makeitlabs/ratt/README.md

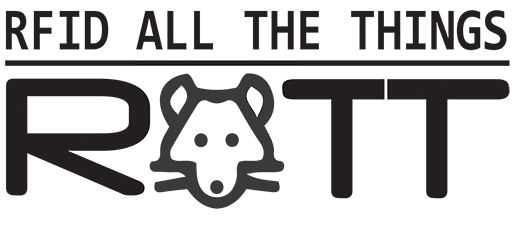
[picture p1: logo/ratt logo 512.png]
RATT - RFID All The Things


Ongoing effort to expand and improve our RFID access control system beyond building doors and onto tools and equipment.
