makeitlabs/ratt/hardware/README.md

# RATT Hardware

- `ratt` - RATT hardware design (schematic, PCB)
