makeitlabs/ratt/hardware/ratt/README.md

# RATT Logic Board

Design, fabrication files, and assembly documentation for the RATT logic board.

- `REV0` - Initial prototype (white PCB) - February 2018
- `REV1` - Design fixes (black PCB) - December 2018
