makeitlabs/ratt/attic/esp32/README.md

# ESP32 Platform projects for remote nodes

https_client_certs is adapted from an esp-idf example and demonstrates 2-way authenticated and encrypted communications from an ESP32 to our MakeItLabs authbackend (or other https site configured properly).
