makeitlabs/ratt/doc/Logic Board Block Diagram.png

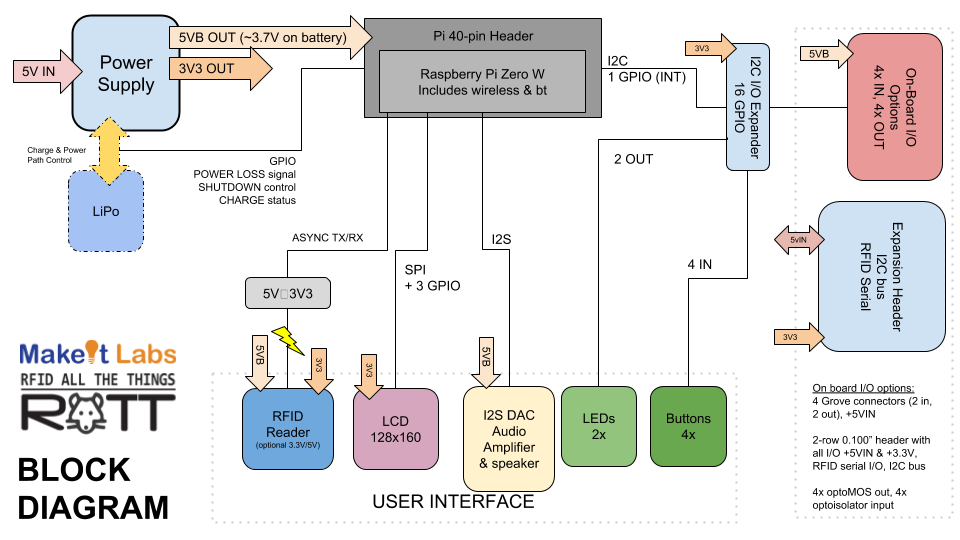
doc/Logic Board Block Diagram.png
