makeitlabs/ratt/doc/Logic Board IO Options.png

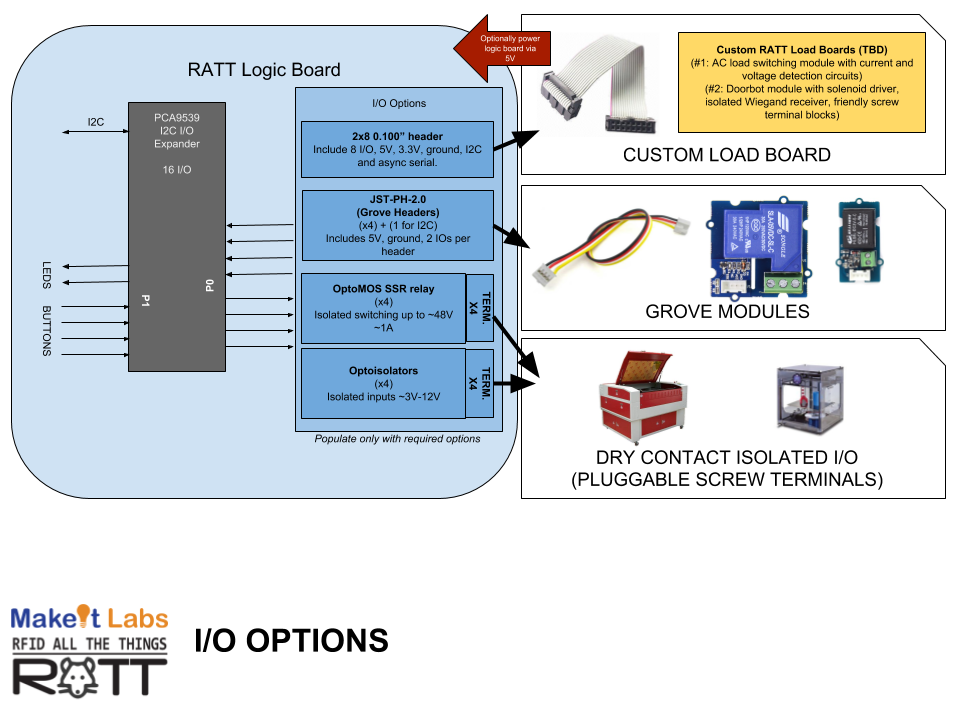
doc/Logic Board IO Options.png
