makeitlabs/ratt/hardware/ratt/references/17492753_10210264934192046_4826887455486719309_o.jpg

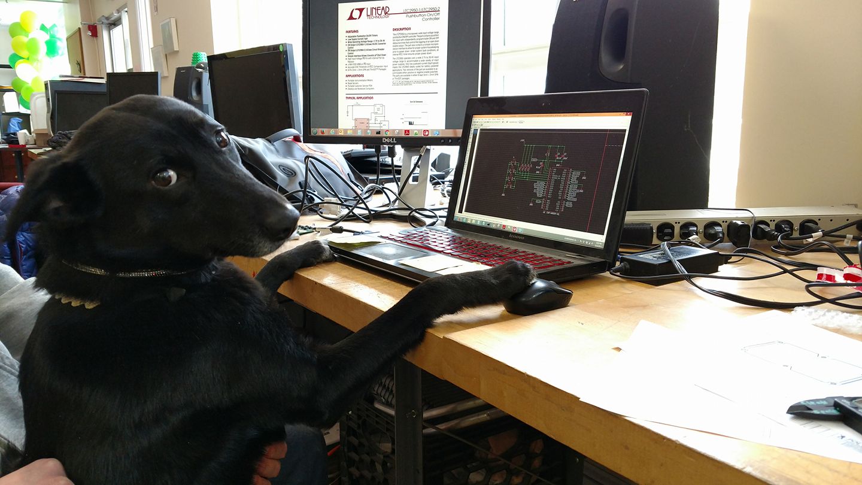
hardware/ratt/references/17492753_10210264934192046_4826887455486719309_o.jpg
