makeitlabs/ratt/hardware/ratt/references/flat,800x800,070,f.u1.bmp

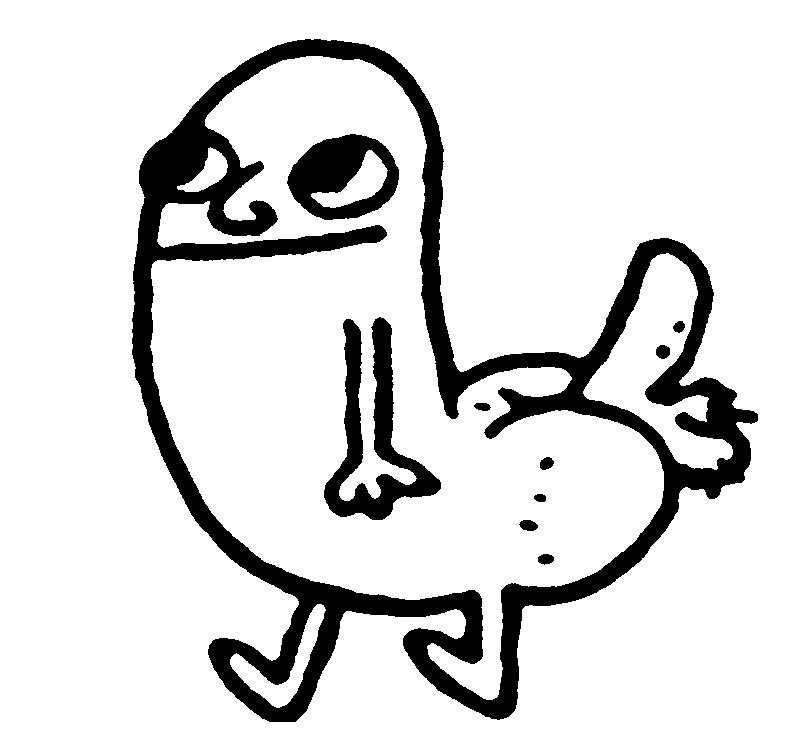
hardware/ratt/references/flat,800x800,070,f.u1.bmp
