makeitlabs/ratt/integration/AlphaBandsaw/Alpha Bandsaw RATT.png

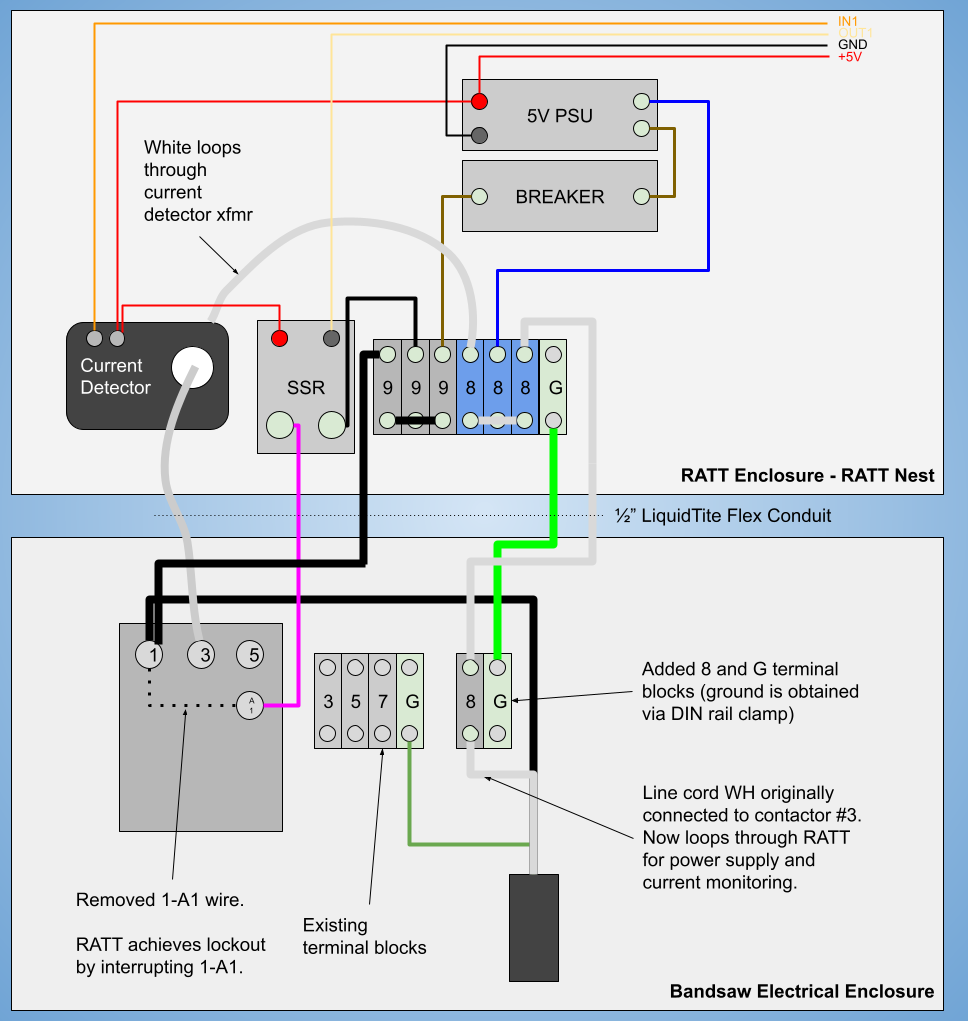
integration/AlphaBandsaw/Alpha Bandsaw RATT.png
