makeitlabs/ratt/integration/AutoLift/doc/Auto Lift - RATTsnest.png

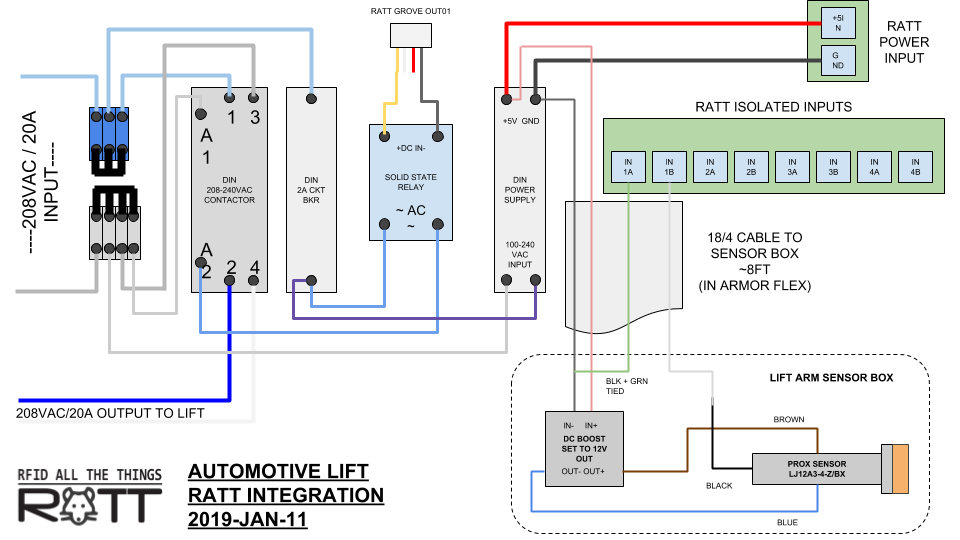
integration/AutoLift/doc/Auto Lift - RATTsnest.png
