makeitlabs/ratt/integration/FullSpectrumLaser/doc/Full Spectrum RATT Integration.png

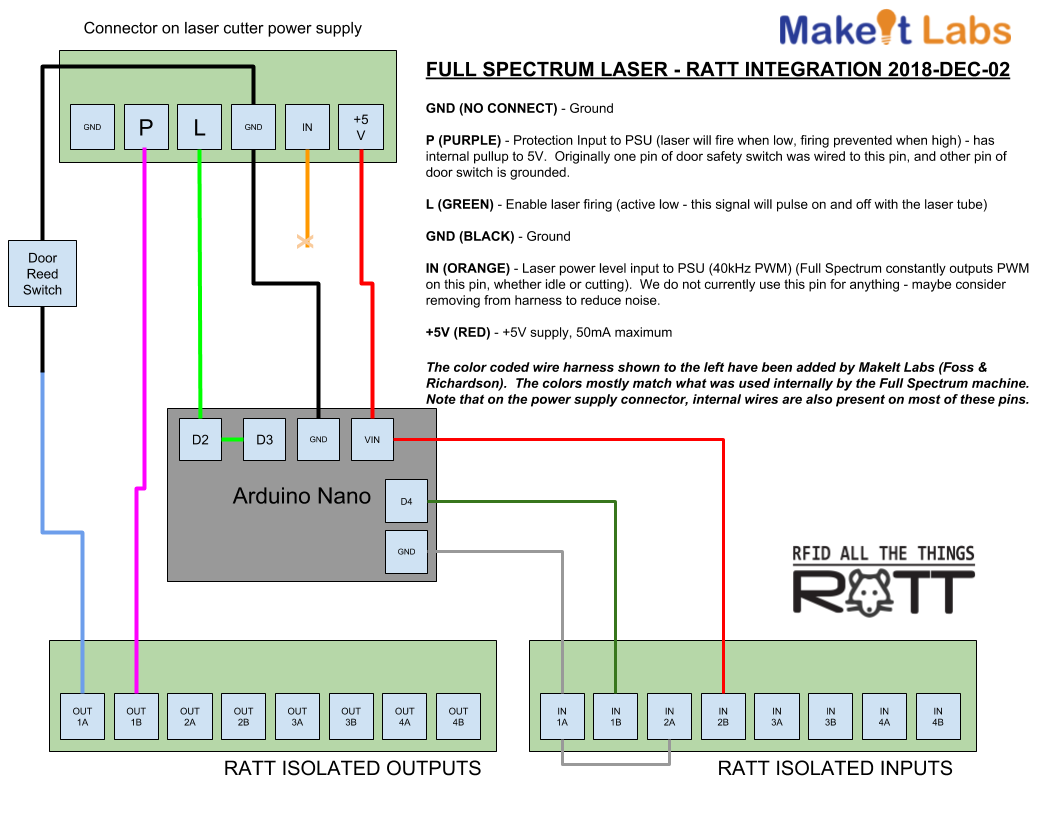
integration/FullSpectrumLaser/doc/Full Spectrum RATT Integration.png
