makeitlabs/ratt/integration/RabbitLaser/doc/Rabbit Laser Integration.png

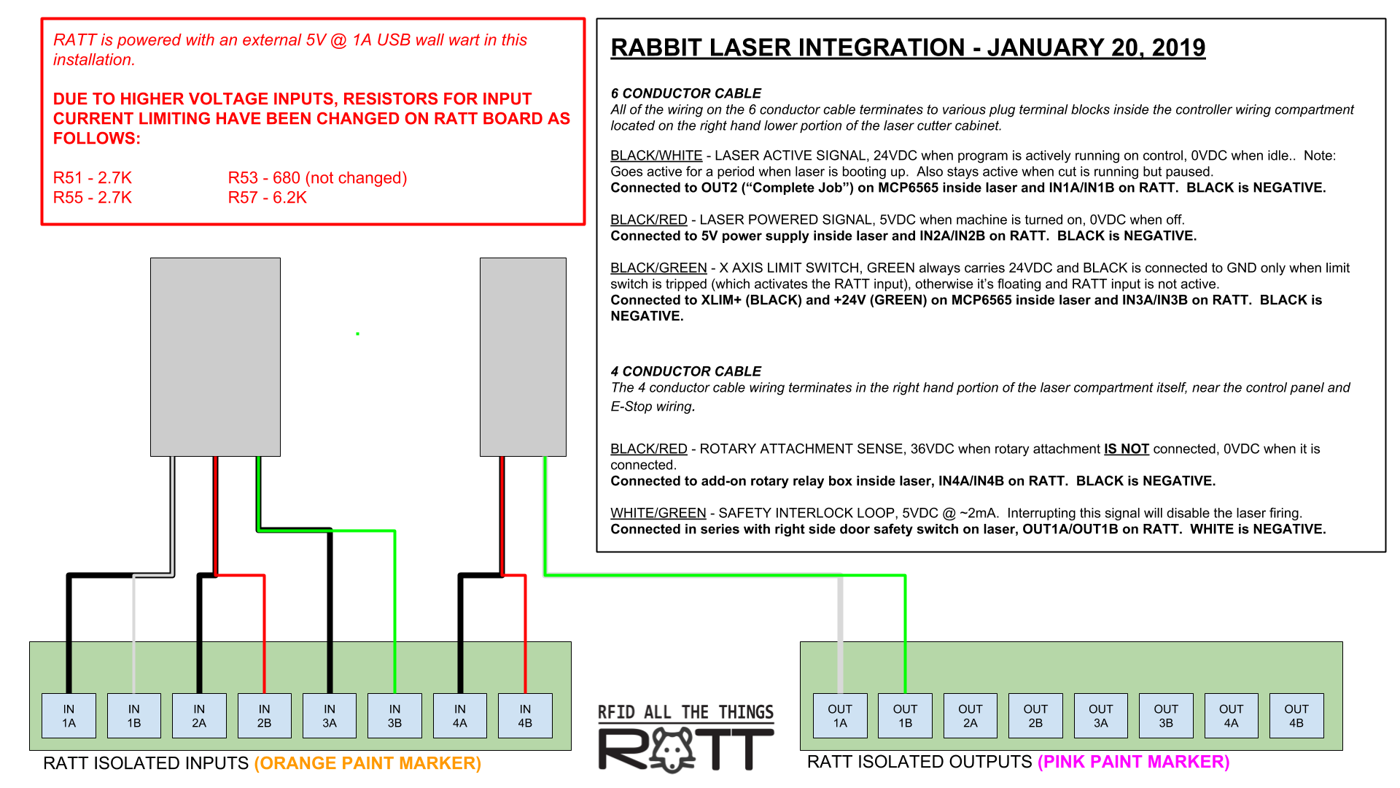
integration/RabbitLaser/doc/Rabbit Laser Integration.png
