makeitlabs/ratt/hardware/ratt/references/1.8-TFT-breakout-master/1.8-TFT-breakout-master/jdt1800-bob.dxf

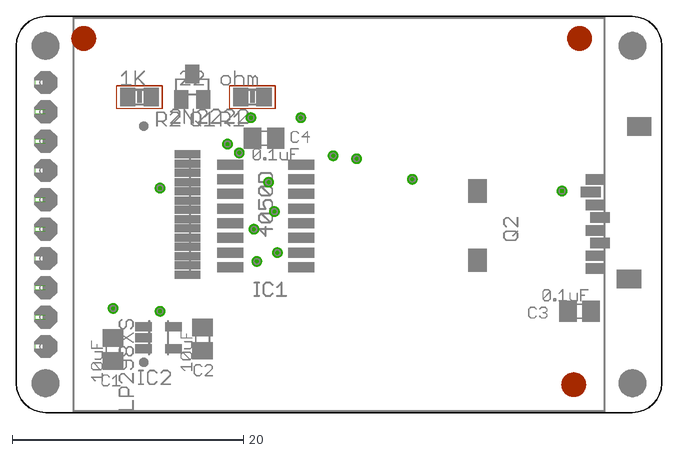
[picture p12: CAD file, 2018-01-27]
hardware/ratt/references/1.8-TFT-breakout-master/1.8-TFT-breakout-master/jdt1800-bob.dxf
55.9 x 34.3
