makeitlabs/ratt/integration/AutoLift/mechanical/led_strip_bulkhead4.stl

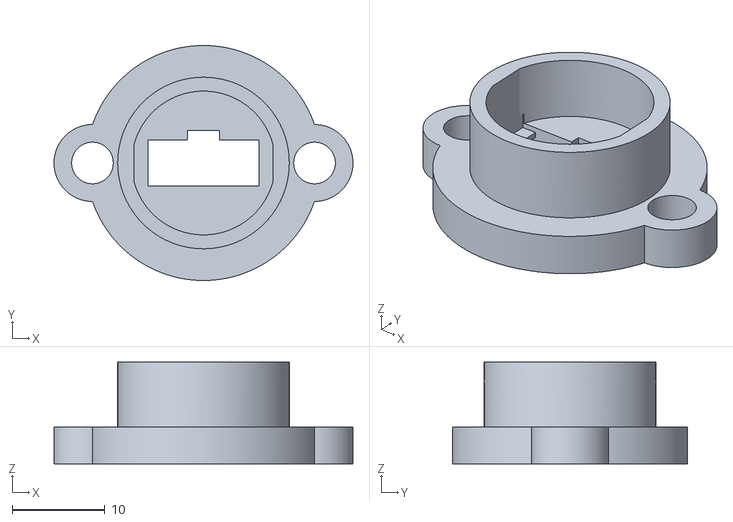
[picture p13: CAD file, 2019-03-21]
integration/AutoLift/mechanical/led_strip_bulkhead4.stl
32.3 x 25.4 x 11.0
