makeitlabs/ratt/logo/MakeIt Labs Logo 2016.dxf

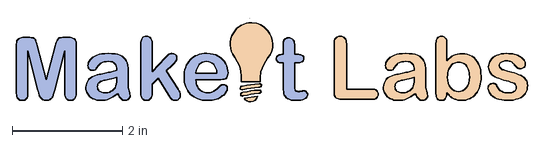
[picture p14: CAD file, 2020-12-24]
logo/MakeIt Labs Logo 2016.dxf
9.25 x 1.52 in
