makeitlabs/ratt/mechanical/RATT_Enclosure_Footprint.dxf

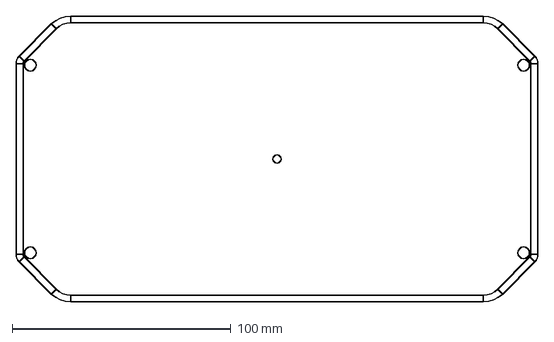
[picture p15: CAD file, 2019-01-23]
mechanical/RATT_Enclosure_Footprint.dxf
238.4 x 130.7 mm
