makeitlabs/ratt/integration/AutoLift/mechanical/led_strip_bulkhead2.stl

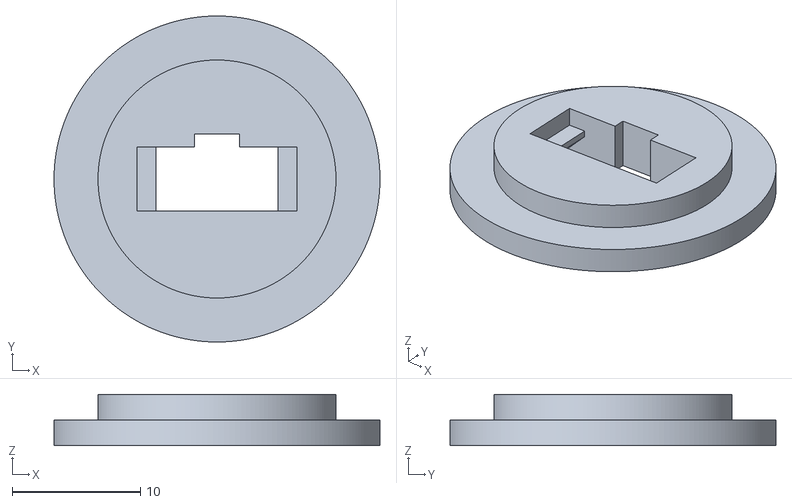
[picture p16: CAD file, 2019-03-21]
integration/AutoLift/mechanical/led_strip_bulkhead2.stl
25.4 x 25.4 x 4.00
