makeitlabs/ratt/logo/ratt logo.dxf

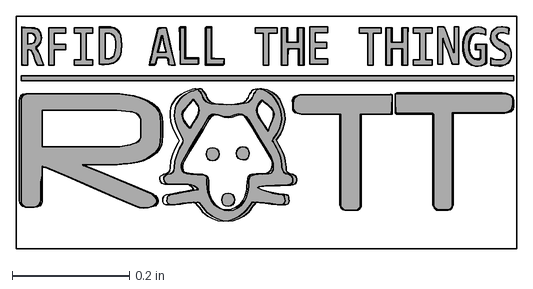
[picture p17: CAD file, 2020-12-24]
logo/ratt logo.dxf
0.853 x 0.396 in
