makeitlabs/ratt/mechanical/phoenix_support_with_rfid.stl

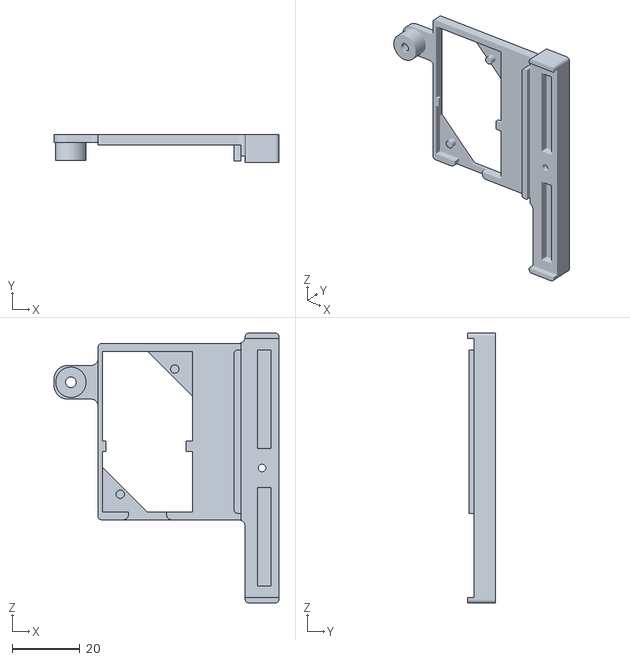
[picture p18: CAD file, 2019-01-10]
mechanical/phoenix_support_with_rfid.stl
66.6 x 8.35 x 80.0
