makeitlabs/ratt/integration/AutoLift/mechanical/led_strip_bulkhead1.stl

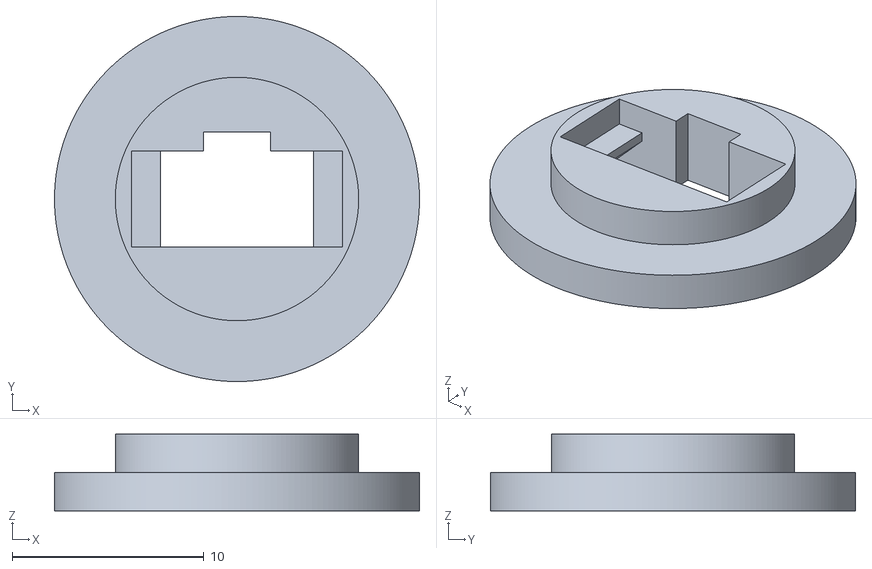
[picture p19: CAD file, 2019-03-21]
integration/AutoLift/mechanical/led_strip_bulkhead1.stl
19.0 x 19.0 x 4.00
