makeitlabs/ratt/mechanical/display_standoff.stl

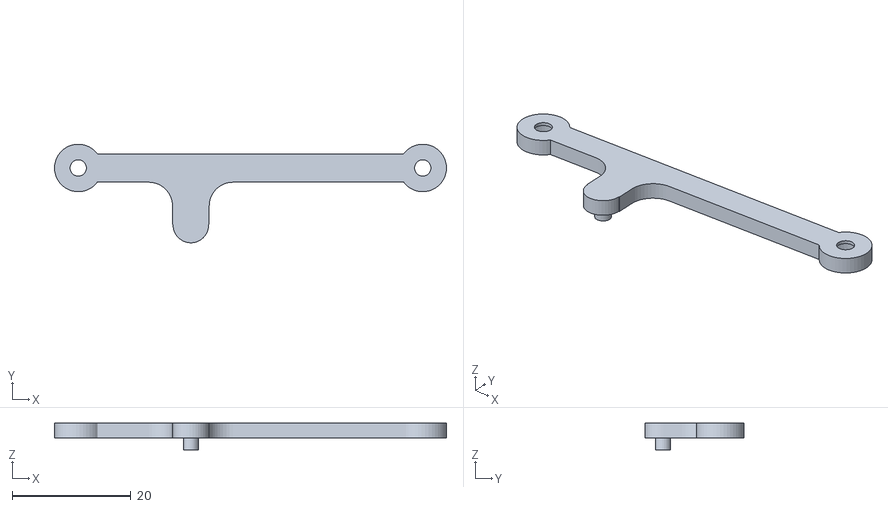
[picture p20: CAD file, 2018-12-31]
mechanical/display_standoff.stl
66.0 x 16.6 x 4.54
