makeitlabs/ratt/integration/AutoLift/mechanical/clamp_lower_sensor_12mm.stl

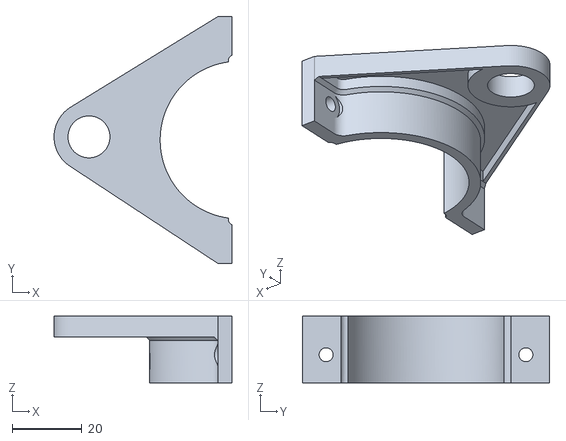
[picture p21: CAD file, 2019-03-21]
integration/AutoLift/mechanical/clamp_lower_sensor_12mm.stl
50.9 x 70.7 x 19.0
