makeitlabs/ratt/mechanical/speaker_resonator.stl

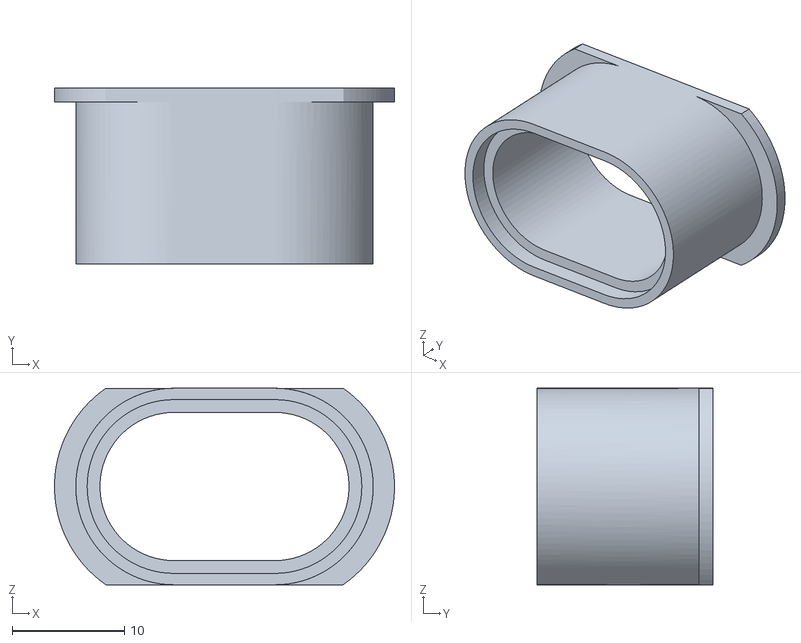
[picture p22: CAD file, 2018-12-31]
mechanical/speaker_resonator.stl
30.3 x 15.7 x 17.5
