makeitlabs/ratt/integration/AutoLift/mechanical/led_strip_bulkhead3.stl

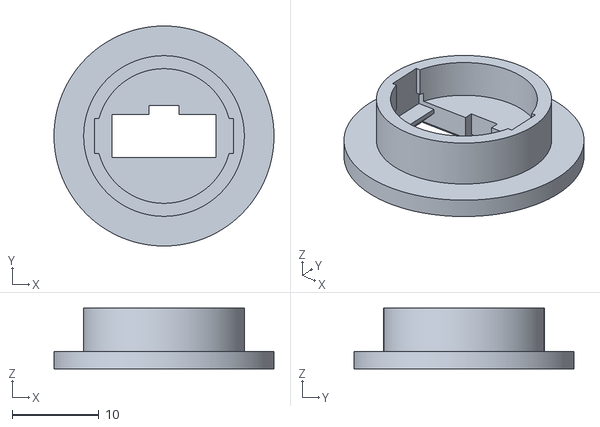
[picture p23: CAD file, 2019-03-21]
integration/AutoLift/mechanical/led_strip_bulkhead3.stl
25.4 x 25.4 x 7.00
