makeitlabs/ratt/mechanical/pi_standoff_2.stl

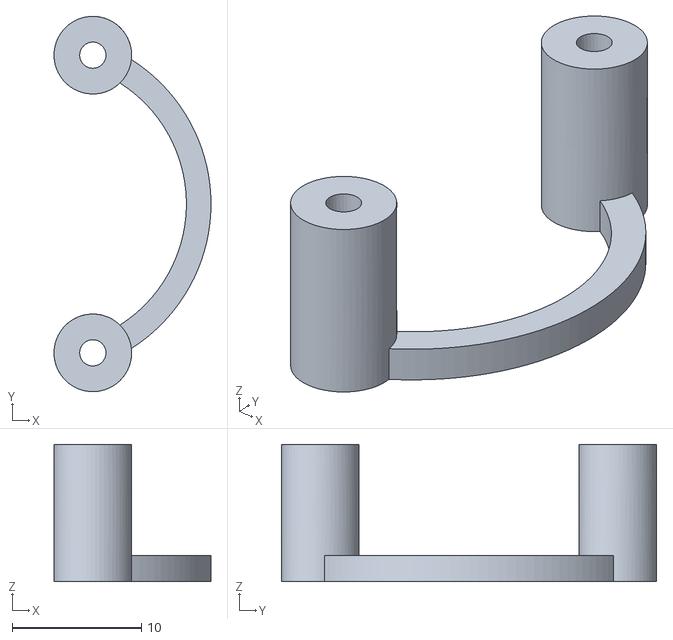
[picture p24: CAD file, 2018-12-31]
mechanical/pi_standoff_2.stl
12.1 x 29.0 x 10.6
