makeitlabs/ratt/integration/AutoLift/mechanical/indicator_acrylic_3mm.dxf

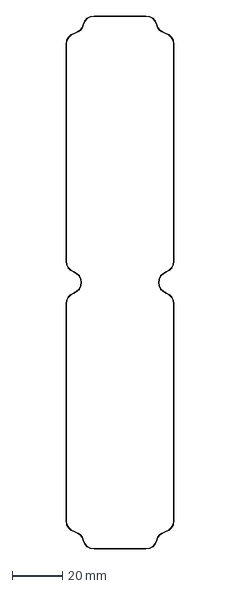
[picture p25: CAD file, 2019-01-31]
integration/AutoLift/mechanical/indicator_acrylic_3mm.dxf
43.0 x 213.0 mm
