makeitlabs/ratt/mechanical/pi_standoff_1.stl

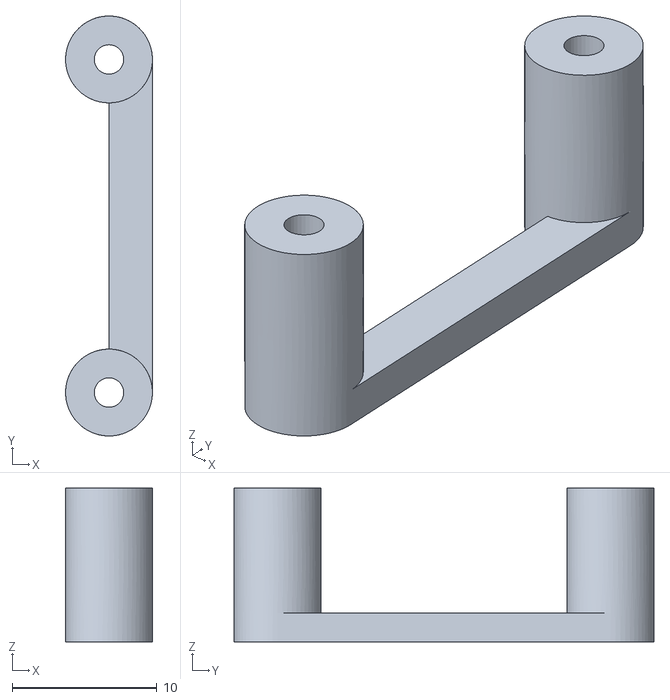
[picture p26: CAD file, 2018-12-31]
mechanical/pi_standoff_1.stl
6.00 x 29.0 x 10.6
