makeitlabs/ratt/integration/AutoLift/mechanical/indicator_bottom.stl

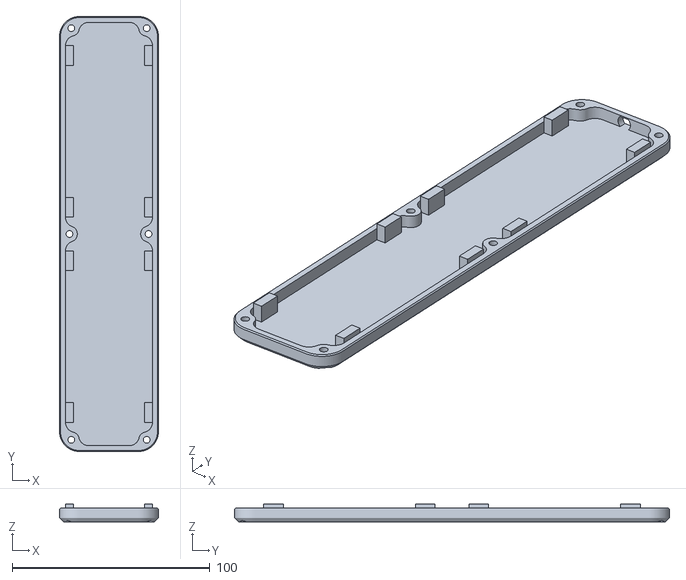
[picture p27: CAD file, 2019-01-31]
integration/AutoLift/mechanical/indicator_bottom.stl
50.0 x 220.0 x 9.00
