makeitlabs/ratt/integration/AutoLift/mechanical/indicator_top.stl

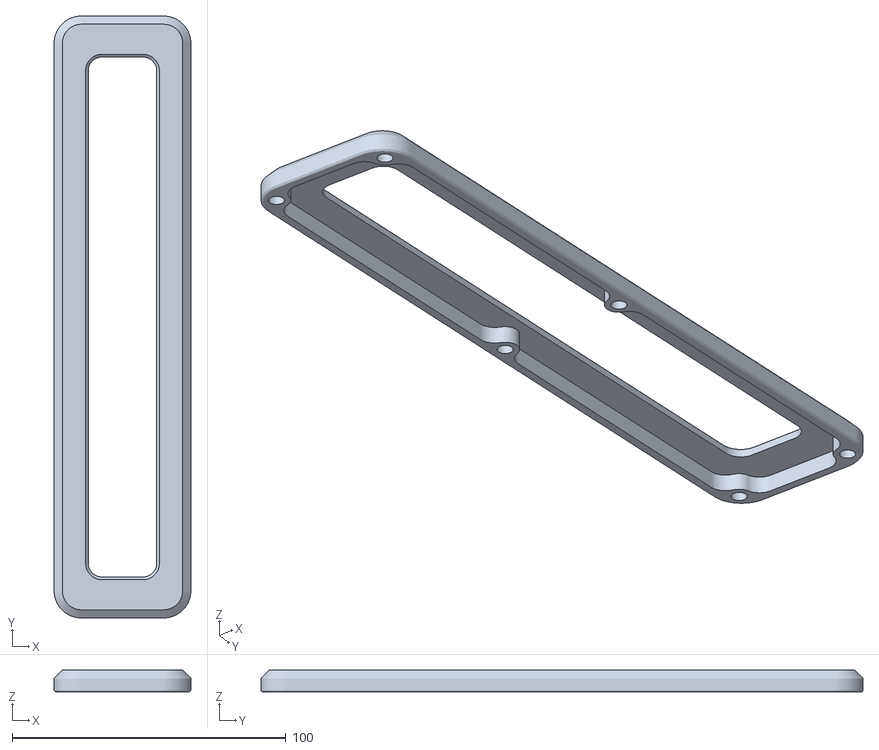
[picture p28: CAD file, 2019-01-31]
integration/AutoLift/mechanical/indicator_top.stl
50.0 x 220.0 x 8.00
