makeitlabs/ratt/integration/AutoLift/mechanical/indicator_separator.stl

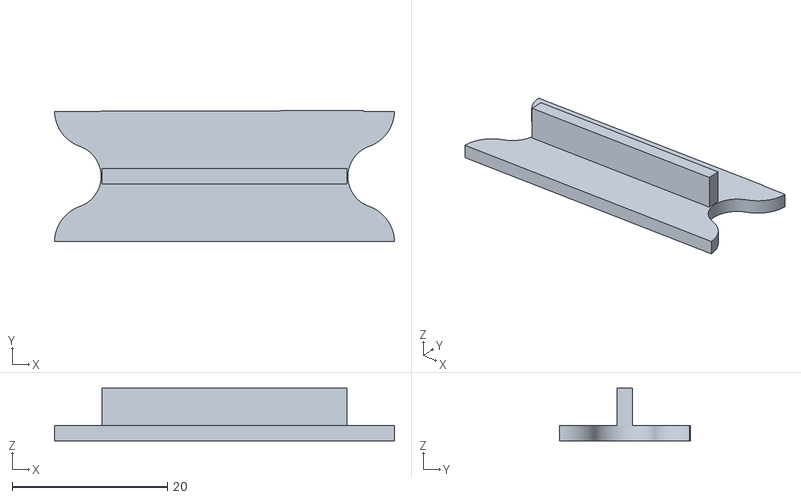
[picture p29: CAD file, 2019-01-31]
integration/AutoLift/mechanical/indicator_separator.stl
43.8 x 16.9 x 6.80
