makeitlabs/ratt/integration/AutoLift/mechanical/clamp_lower1.stl

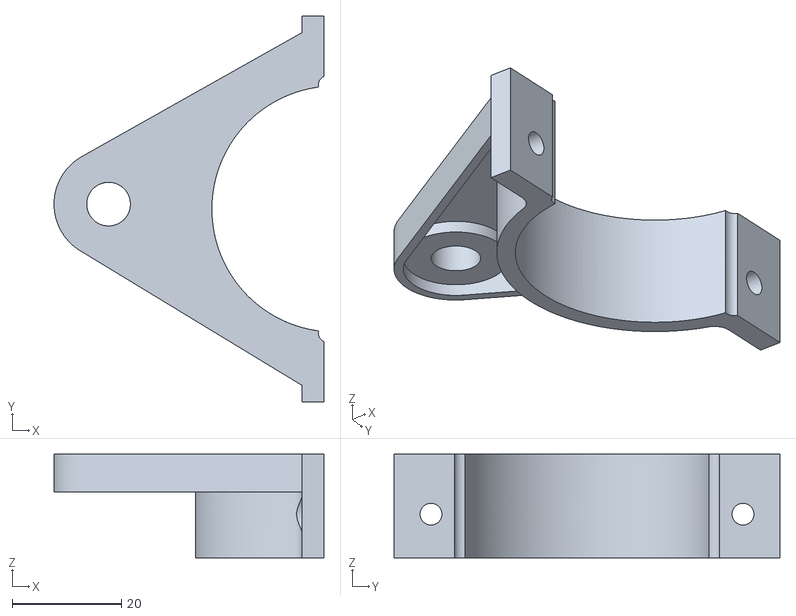
[picture p30: CAD file, 2019-01-23]
integration/AutoLift/mechanical/clamp_lower1.stl
49.5 x 70.7 x 19.0
