makeitlabs/ratt/integration/AutoLift/mechanical/clamp_upper1.stl

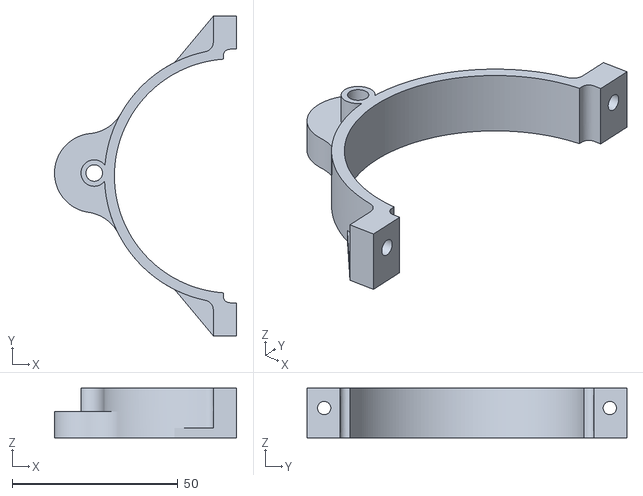
[picture p31: CAD file, 2019-01-23]
integration/AutoLift/mechanical/clamp_upper1.stl
55.0 x 96.6 x 15.0
