makeitlabs/ratt/integration/AutoLift/mechanical/clamp_upper2.stl

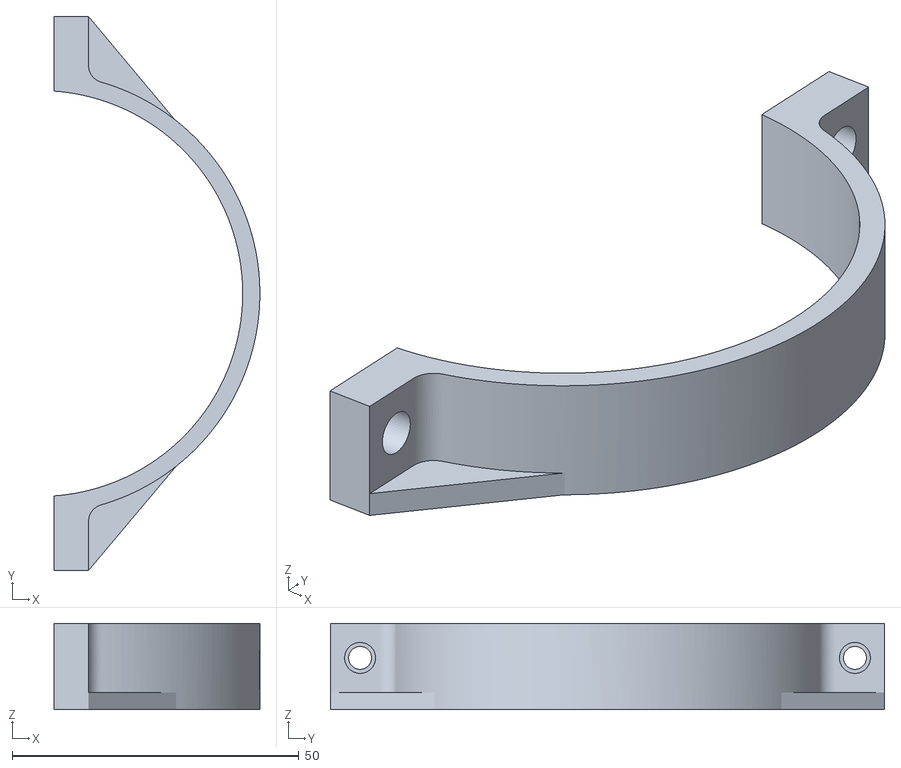
[picture p32: CAD file, 2019-01-23]
integration/AutoLift/mechanical/clamp_upper2.stl
35.9 x 96.6 x 15.0
