makeitlabs/ratt/integration/AutoLift/mechanical/clamp_lower2.stl

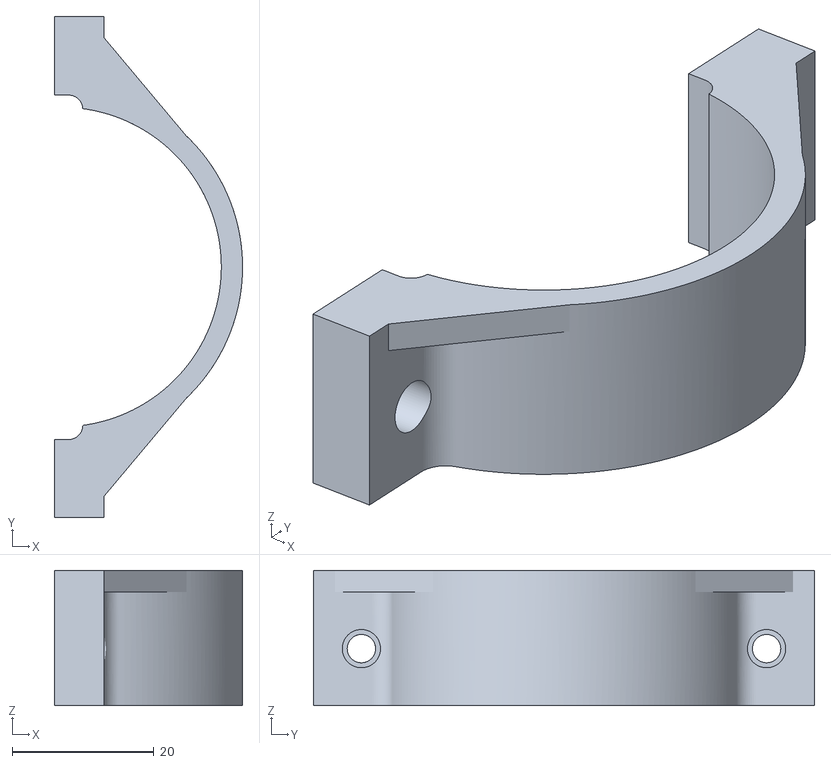
[picture p33: CAD file, 2019-01-23]
integration/AutoLift/mechanical/clamp_lower2.stl
26.5 x 70.7 x 19.0
