makeitlabs/ratt/(list of files, cad)

Other CAD files:
hardware/ratt/REV0/assembly/RATT_REV0.dxf
hardware/ratt/REV0/assembly/RATT_TOP0.dxf
integration/Deprecated/FullSpectrumLaser/mechanical/Bottom Half Plate for Arduino Screw Terminal Breakout.dxf
integration/FullSpectrumLaser/mechanical/Bottom Half Plate for Arduino Screw Terminal Breakout.dxf
