makeitlabs/ratt/(threads)

Thread 1 (2019-01-25):

PersonalityLaserCutter: Flaws in homing/power logic

tangentaudio, 2019-01-25:
When the laser cutter personality is used with the homing requirement enabled, there are some instances where the user may home the laser but RATT cannot detect this due tot he narrow window in which homing is expected.

Possible fixes:

- force homing upon detection of laser powerup instead of upon RFID badge-in (minor downside: can't report homing failure by user, since they would not be badged in yet)
- detect homed condition during idle loop (may not reliably detect given RATT may transition into other states, or may have to make code super ugly to detect in multiple places)
- don't boot user out of 'homing required' state if laser activity detected, play warning and keep requiring homing
- homing signal from laser is momentary, so possibly add hardware latch that resets whenever laser is power cycled - this means RATT would see that the laser had been homed no matter when it was done, and the homing state would be retained as long as laser was powered.  (downside: adding hardware, level conversions between 24V homing signal, etc.)

tangentaudio, 2019-02-02:
There's another issue that occasionally comes up.  Due to the way the Rabbit laser controller works at bootup, it indicates to RATT that it is active for the duration of the controller bootup process (5-10 seconds).  If someone tags into RATT right after powering it up, RATT thinks they started a job and will complain.

It might be nice to have an optional sequence after tool powerup detected to make sure the active state goes active then inactive, and puts up a nice friendly message to tell the user to wait for the laser to boot.  RFID reads would be ignored during this time.

tangentaudio, 2020-10-06:
I believe there is also a memory leak in some part of this RATT personality.  The Rabbit laser is the only one of the four deployed which will get slow/unresponsive after a period of time of running.  My guess is possibly in the QML with the audio prompts that play, but that's purely a shot in the dark.  Needs investigation.

tangentaudio, 2022-08-22:
Since we have retired the Rabbit laser, I am closing this issue.  The bugs still exist, but no longer impact our day-to-day operations.

Closed 2022-08-22.

Thread 2 (2019-01-25):

MQTT logout message missing when homing fails

tangentaudio, 2019-01-25:
Noted on PersonalityLaserCutter - if a user badges in and RATT is asking for homing, but the user starts the laser job instead, RATT will issue a warning and go back to the idle loop.

In that case, RATT will have sent an MQTT personality login message when the user badged in, and another message with the safety failure occurred.  However, it does not send a logout message like it should.

I looked at the code a bit and this should be easy to fix, but currently all logout messages are sent from the QML side (because usually they're accompanied by usage time stats, which are generated in the QML view).

To improve consistency, considering extending the 'uiEvent' (which is sent from QML and used in the personality state machine in Python) to include a json payload which could be used to carry the usage stats, and moving all of the logout messages into the personality state machine.  Then an additional logout message would be added to the state machine to handle this case.

It should be checked whether this same situation occurs with the normal safety failure in PersonalitySimple.  The laser cutter homing routine hooks into the safety check, so if a single fix can be done to address both that is best.

tangentaudio, 2019-02-02:
Fixed by tracking the 'logged in' state inside the member record.  When returning to the idle state, it will check if the 'logged in' flag is still set and issue a logout mqtt message with reason='other'.  Normal logouts will issue the logout mqtt message themselves and then set the member record as logged out so this 'fall through' won't occur.

Closed 2019-02-02.

Thread 4 (2019-01-25):

Timeout for RFID swipe on "Report Issue"

bkgoodman, 2019-01-25:
"Report issue" should have a timeout waiting for the user's RFID swipe. It currently has none. It gets confusing when the next user swipes-in (maybe significantly later) - and inadvertently sends the last-user's pending message, and is not logged in.

(If it does have one - it's probably too long).

tangentaudio, 2019-02-02:
Fixed, there is now a 30 second timeout for the entire issue reporting process.  Keypresses reset the timeout timer.  Also added an "exit (no issue to report" issue as first item, and fixed bug with empty issue report when exiting.

Closed 2019-02-02.

Thread 6 (2019-03-23):

Option to remain logged-in when idle

bkgoodman, 2019-03-23:
When you are working - and clock is ticking down to auto-timeout, it would be nice to have SOME way of preventing this - like [preferably] hitting a button or _even_ re-swiping RFID.

It sucks to watch the clock count down when you're not ready to run - knowing that you'll have to re-badge-in in 15 seconds.

tangentaudio, 2019-03-25:
Yes - this one is easy and I've been meaning to do it.   I think I will allow a button press to restart the countdown.

Re-swiping RFID would at least prevent coat-tailing but I think it's probably a bit too inconvenient to be worth it.  We can also increase the default timeout on the particular tool if it seems a bit too short.

tangentaudio, 2019-03-29:
Fixed, any user may now simply press the blue button when logged in to reset their idle timer to the value configured by `[Personality] TimeoutSeconds` in the config file.

Closed 2019-03-29.

Thread 7 (2019-03-24):

Camera board unaware of power-offs

bkgoodman, 2019-03-24:
Login to resource - use resource - then KIlL POWER to RATT. Camera signboard still things user is using resource - hours later?

tangentaudio, 2019-03-25:
Indeed - there are a few circumstances which can cause this.  This is really an issue with the Node-RED logic running on the backend, I just need to put some time into making it a bit smarter and more robust.

Thread 8 (2019-03-28):

Laser wouldn't work - Half-stuck in "zero-XY mode"?

bkgoodman, 2019-03-28:
I was using the laser - everything was fine. Powering on and off, timing out, re-logging in, etc.

At one point I noticed the RATT was beeping - like it does when it is waiting for Zero-XY. I had already done the homing, and the screen was NOT telling me to do so again. It was a bit of an unexplained annoyance.

At one point I went to cut - and laser would not fire. I checked everything - tried re badging in, even tried re-homing laser. It kept beeping, and still would not fire.

Eventually I killed power to RATT. When it came back up - I homed - and all worked well from there.

tangentaudio, 2022-08-22:
Closing this issue since we have retired the Rabbit laser.  The bugs still exist, but no longer impact day-to-day operation.

Closed 2022-08-22.

Thread 15 (2019-11-15):

Lockout message displays raw JSON

bkgoodman, 2019-11-15:
Currently displays like:
`{"reason":"Maintenance","tool":"laser-rabbit"}`

Should display like:

Something else

tangentaudio, 2020-10-06:
Fixed by brad - merged from PR, tested by Steve.

Closed 2020-10-06.
