makeitlabs/ratt/hardware/ratt/REV1/assembly/RATT_REV1_assembly_connectors.pdf

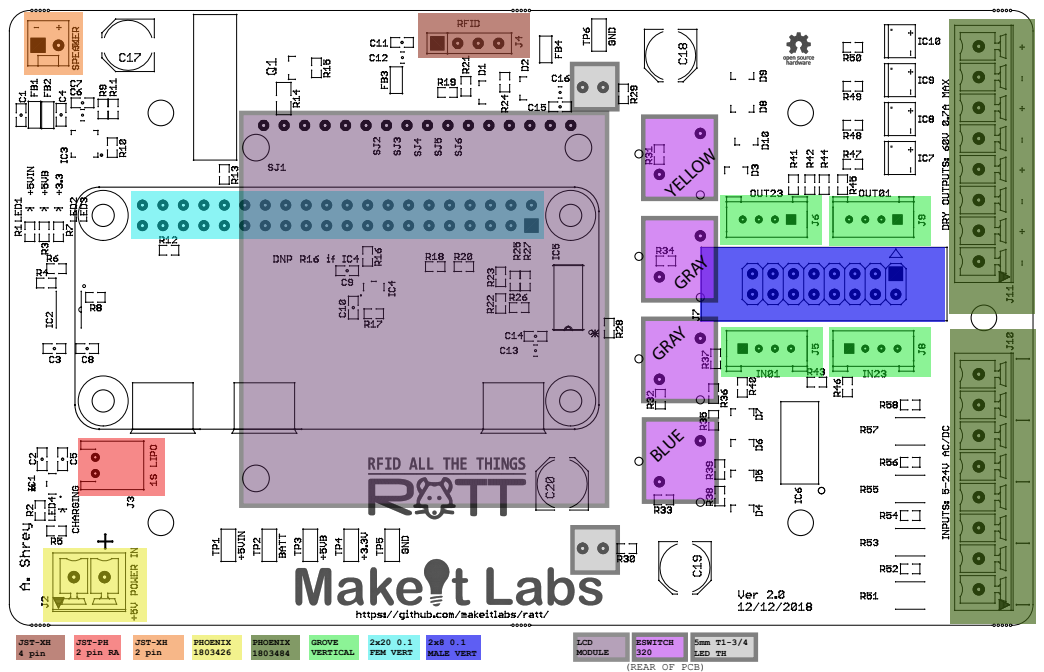
[picture p35: page 1]
JST-XH 4 pin; JST-PH 2 pin RA; JST-XH 2 pin; PHOENIX 1803426; PHOENIX 1803484; GROVE VERTICAL; 2x20 0.1 FEM VERT; 2x8 0.1 MALE VERT; ESWITCH 320; 5mm T1-3/4 LED TH; YELLOW; BLUE; GRAY

LCD
MODULE
(REAR OF PCB)
