makeitlabs/ratt/hardware/ratt/REV1/assembly/RATT_REV1_assembly_other.pdf

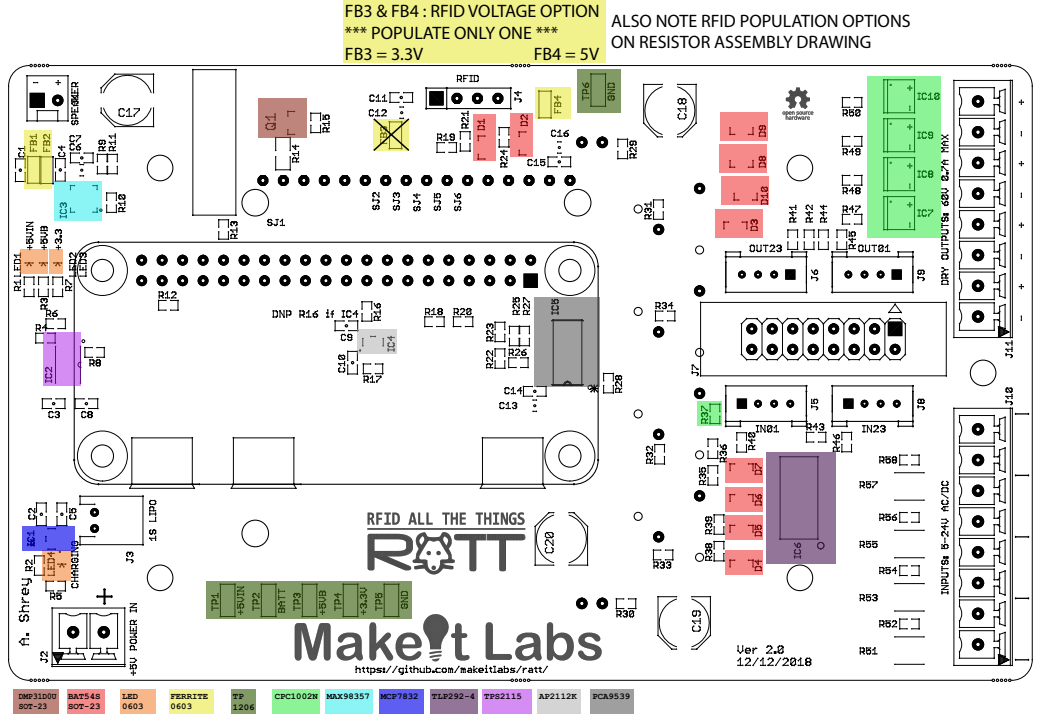
[picture p36: page 1]
DMP31D0U SOT-23; BAT54S SOT-23; LED 0603; FERRITE 0603; CPC1002N MAX98357 MCP7832 TLP292-4 TPS2115 AP2112K PCA9539

FB3 & FB4 : RFID VOLTAGE OPTION
*** POPULATE ONLY ONE ***

ALSO NOTE RFID POPULATION OPTIONS
ON RESISTOR ASSEMBLY DRAWING
