makeitlabs/ratt/hardware/ratt/REV1/assembly/RATT_REV1_assembly_resistors.pdf

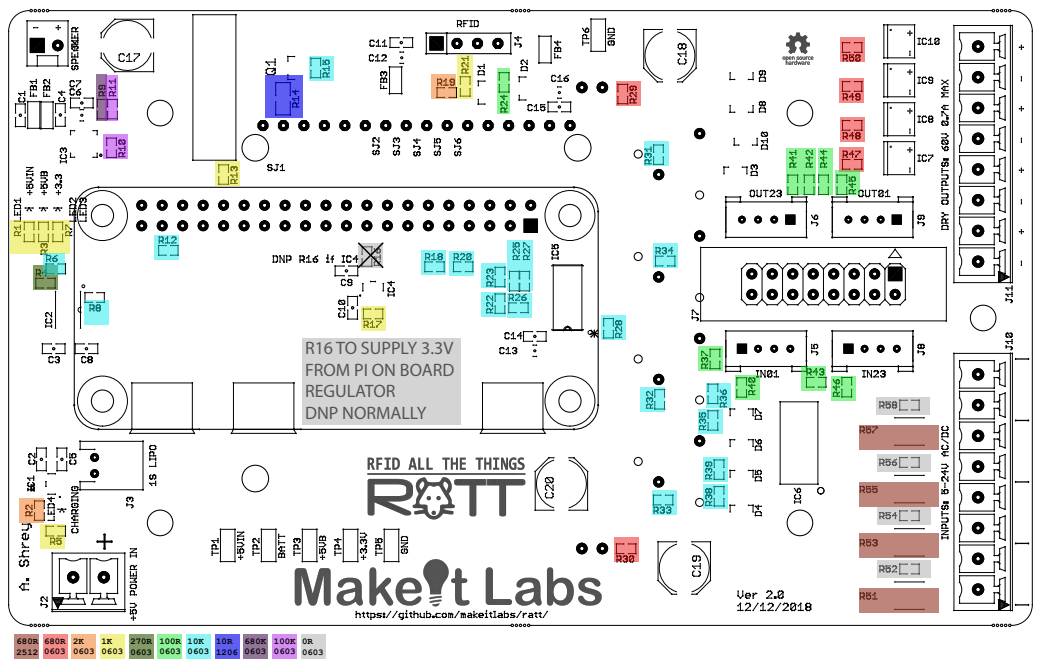
[picture p37: page 1]

R16 TO SUPPLY 3.3V
FROM PI ON BOARD
REGULATOR
DNP NORMALLY
