makeitlabs/ratt/hardware/ratt/REV1/assembly/RATT_REV1_schematic.pdf

## Charge current: I_CHG = 1000 / R_PROG

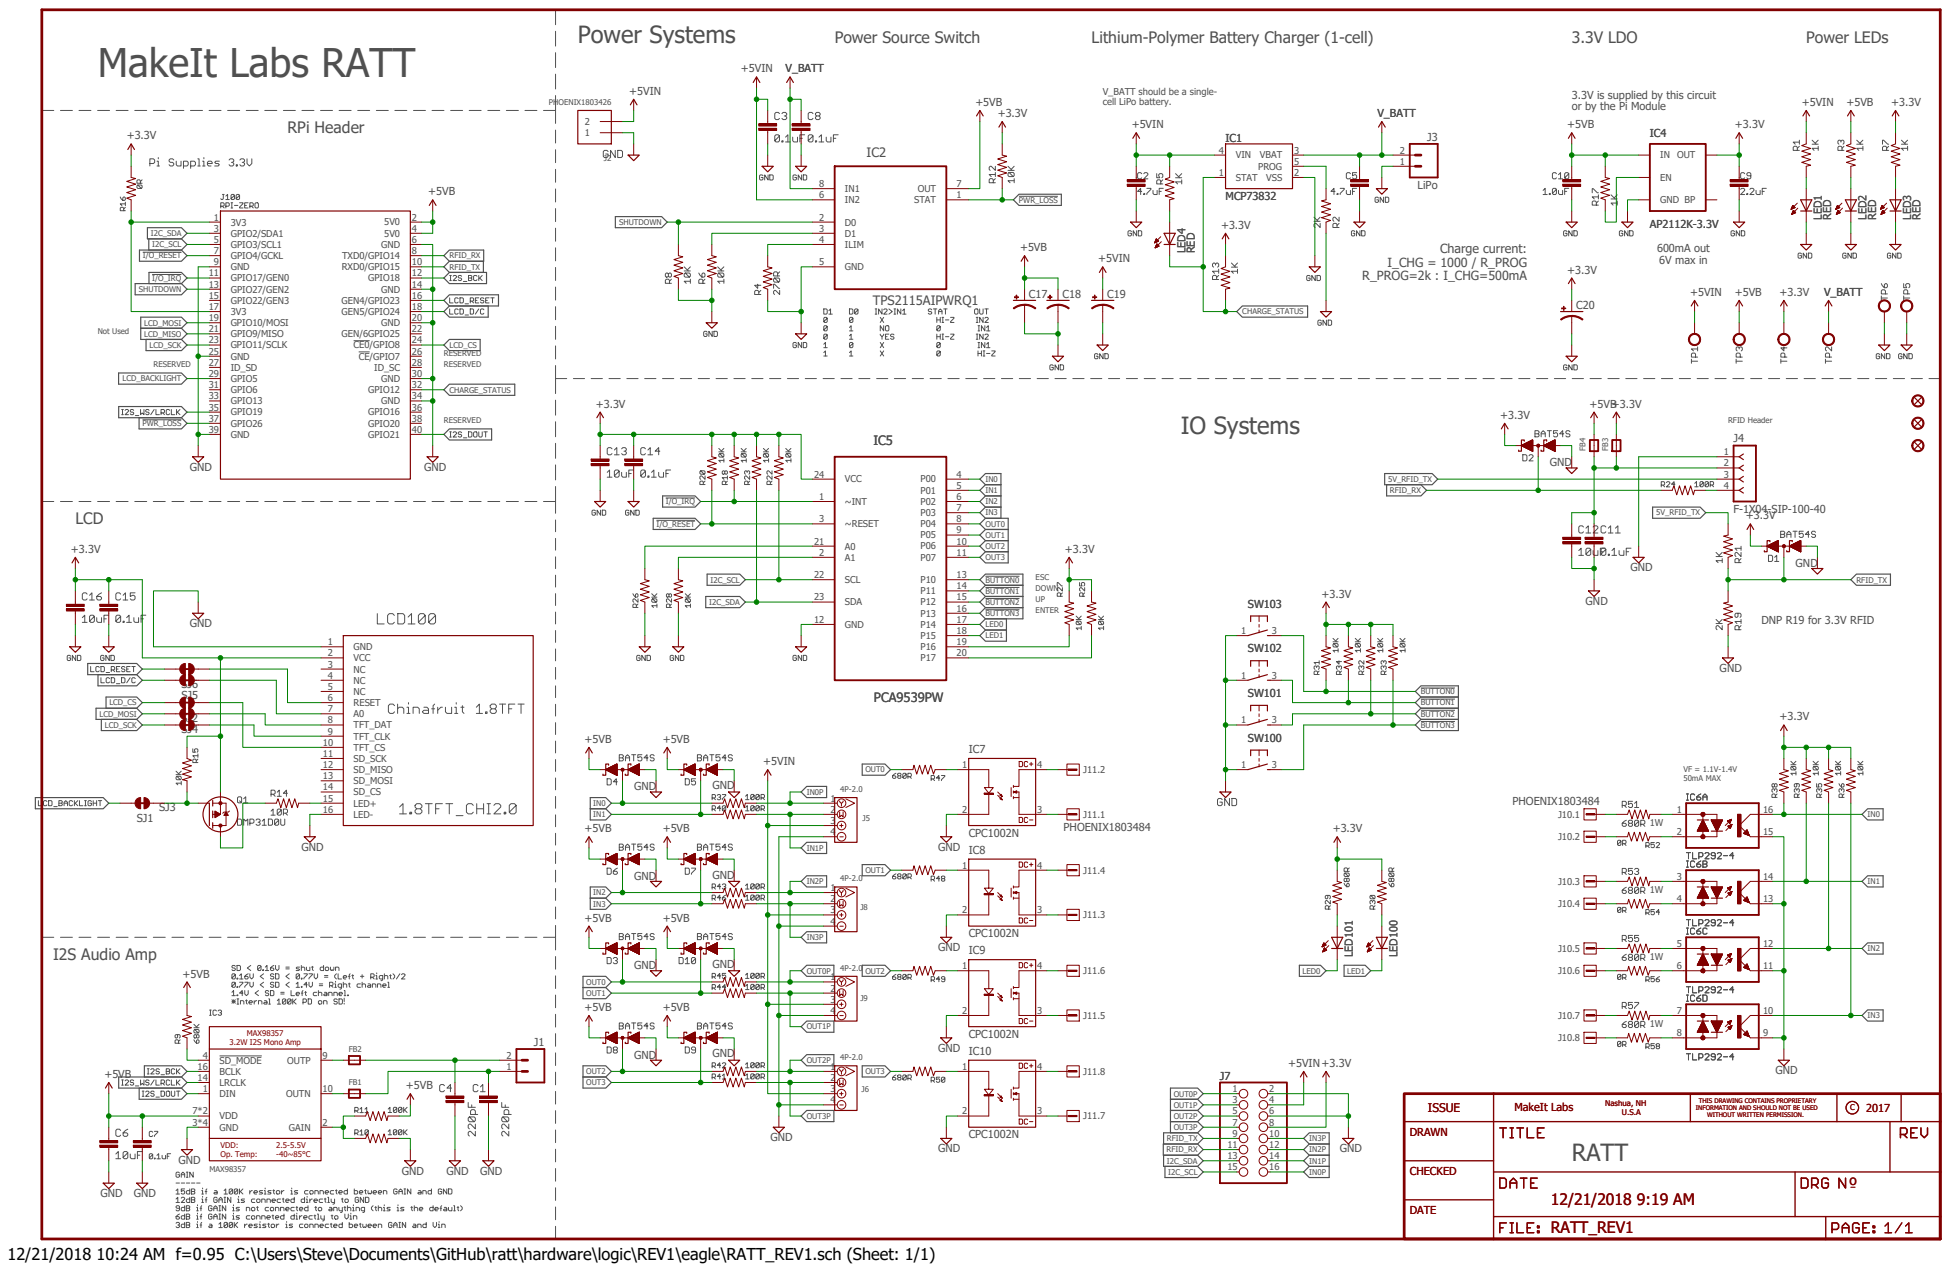
[picture p38: page 1]

Lithium-Polymer Battery Charger (1-cell)

3.3V is supplied by this circuit
or by the Pi Module

12/21/2018 10:24 AM f=0.95 C:\Users\Steve\Documents\GitHub\ratt\hardware\logic\REV1\eagle\RATT_REV1.sch (Sheet: 1/1)
