makeitlabs/ratt/integration/AutoLift/doc/Auto Lift - RATTsnest.pdf

1 3
A

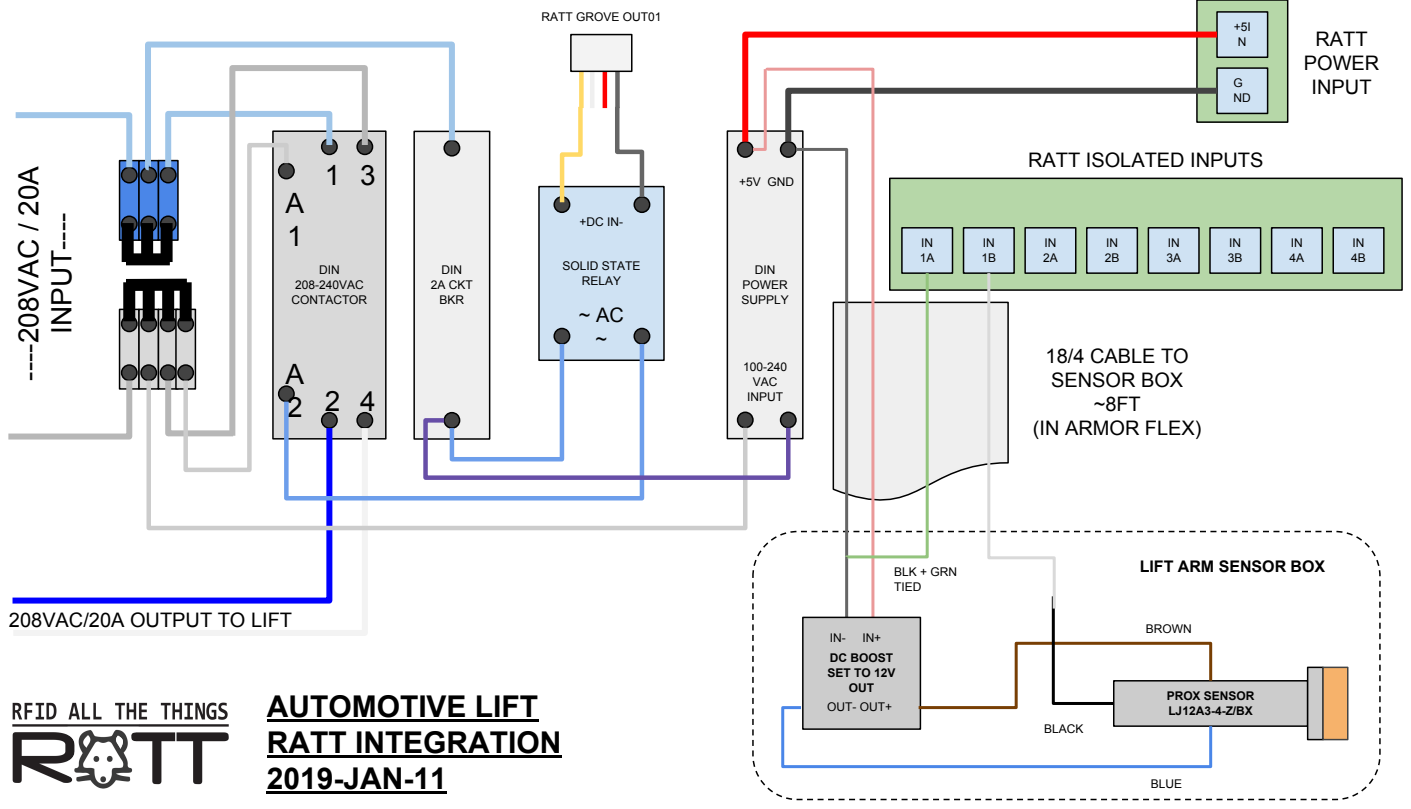
[picture p39: page 1]
DIN 208-240VAC CONTACTOR; DIN 2A CKT BKR; SOLID STATE RELAY; DIN POWER SUPPLY; 100-240 VAC INPUT; +5V GND; ----208VAC / 20A; INPUT----; RATT POWER INPUT; RATT GROVE OUT01; DC BOOST SET TO 12V OUT; OUT- OUT+; PROX SENSOR LJ12A3-4-Z/BX; BROWN; BLUE; BLACK; 18/4 CABLE TO SENSOR BOX ~8FT; BLK + GRN TIED; AUTOMOTIVE LIFT RATT INTEGRATION 2019-JAN-11

RATT ISOLATED INPUTS

(IN ARMOR FLEX)

LIFT ARM SENSOR BOX

208VAC/20A OUTPUT TO LIFT
