makeitlabs/ratt/mechanical/Polycase_DC85F.pdf

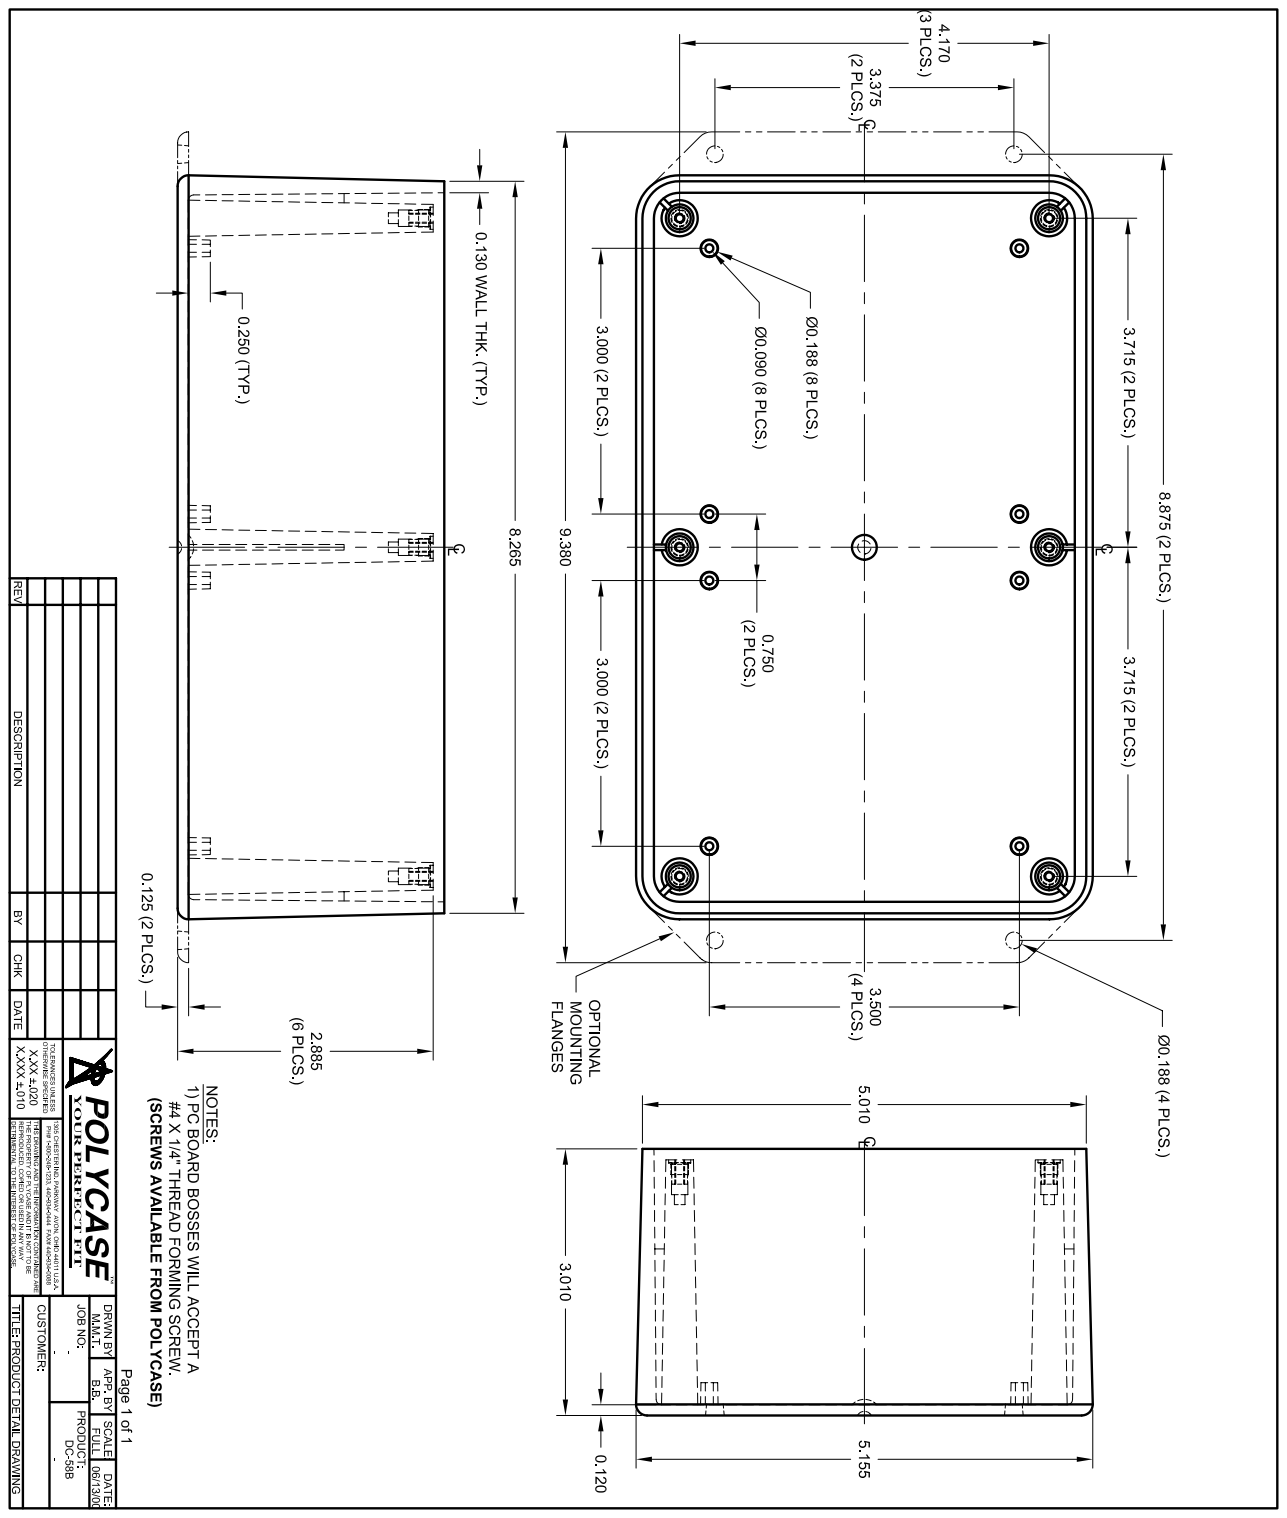
[picture p40: page 1]

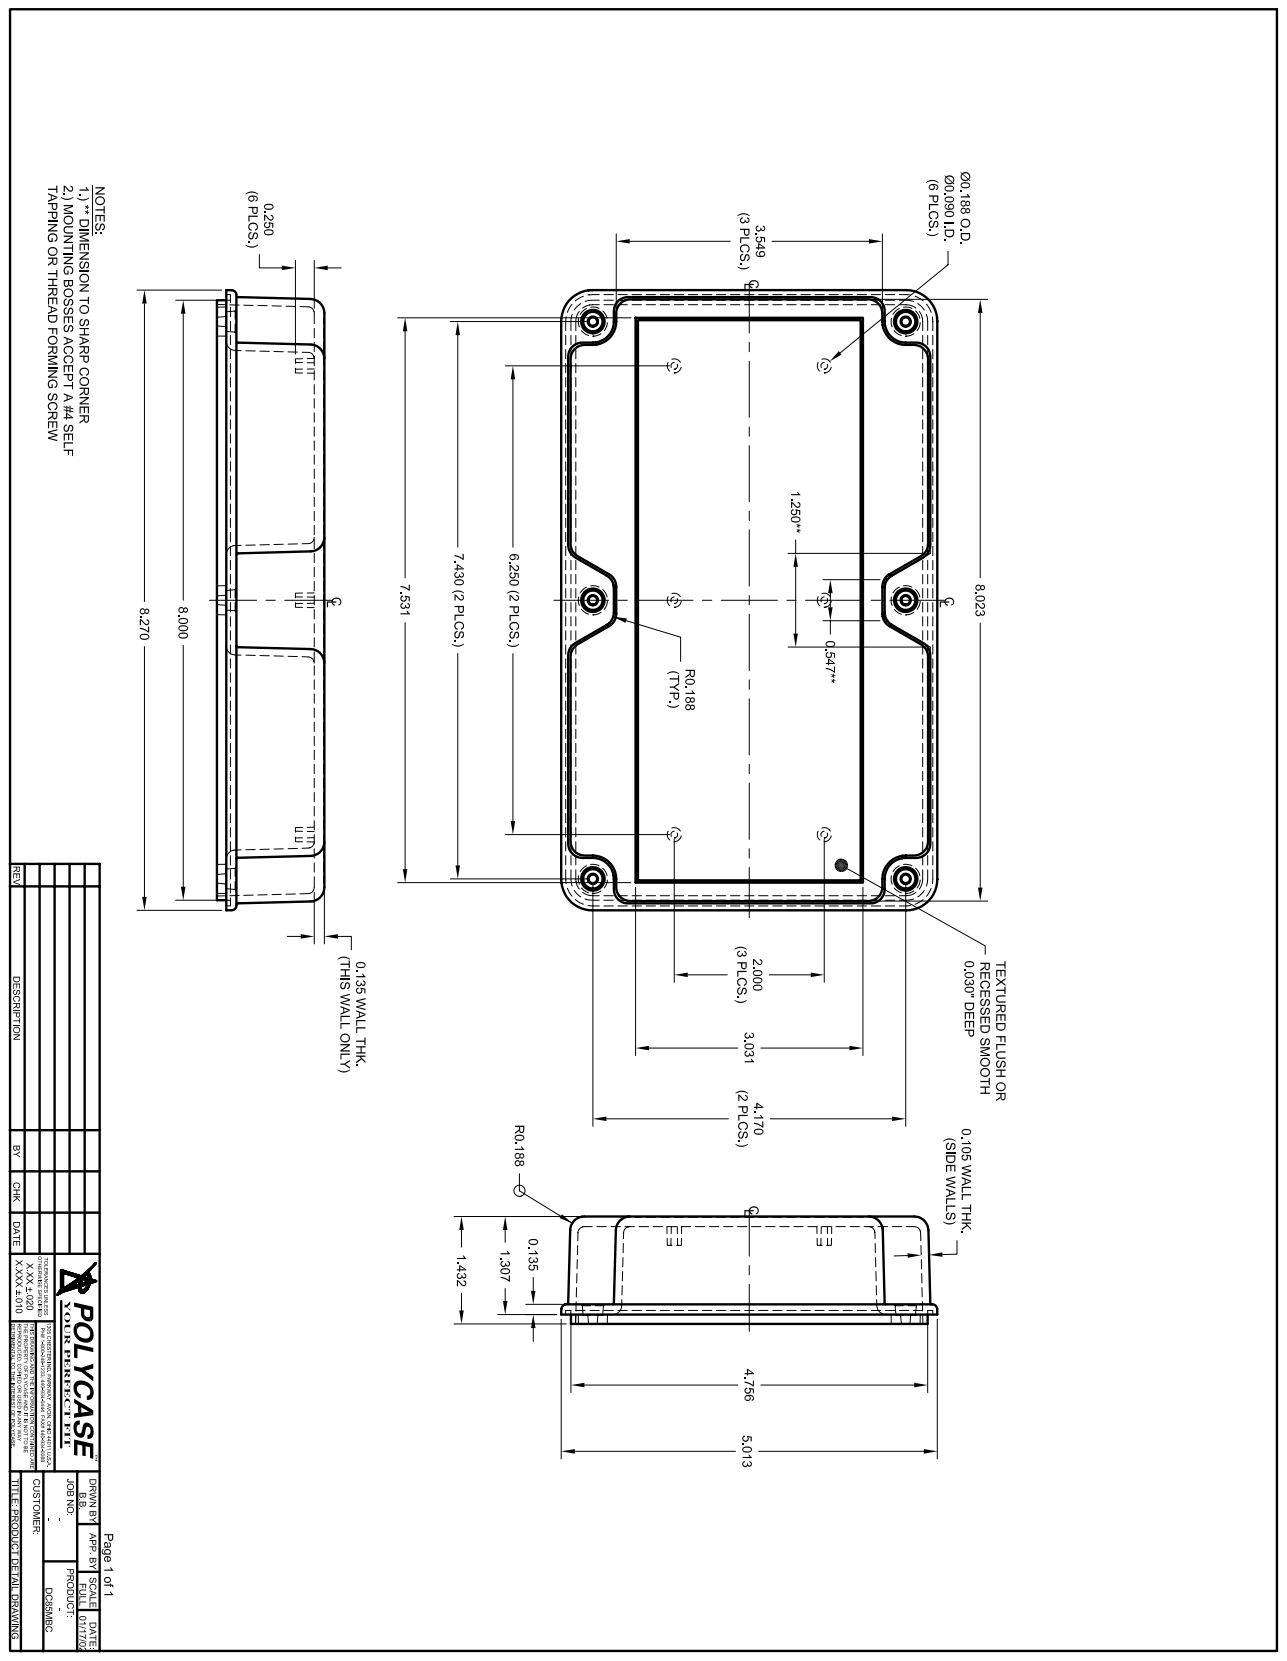
[picture p41: page 2]
