makeitlabs/ratt/mechanical/RATT_Enclosure_Footprint.pdf

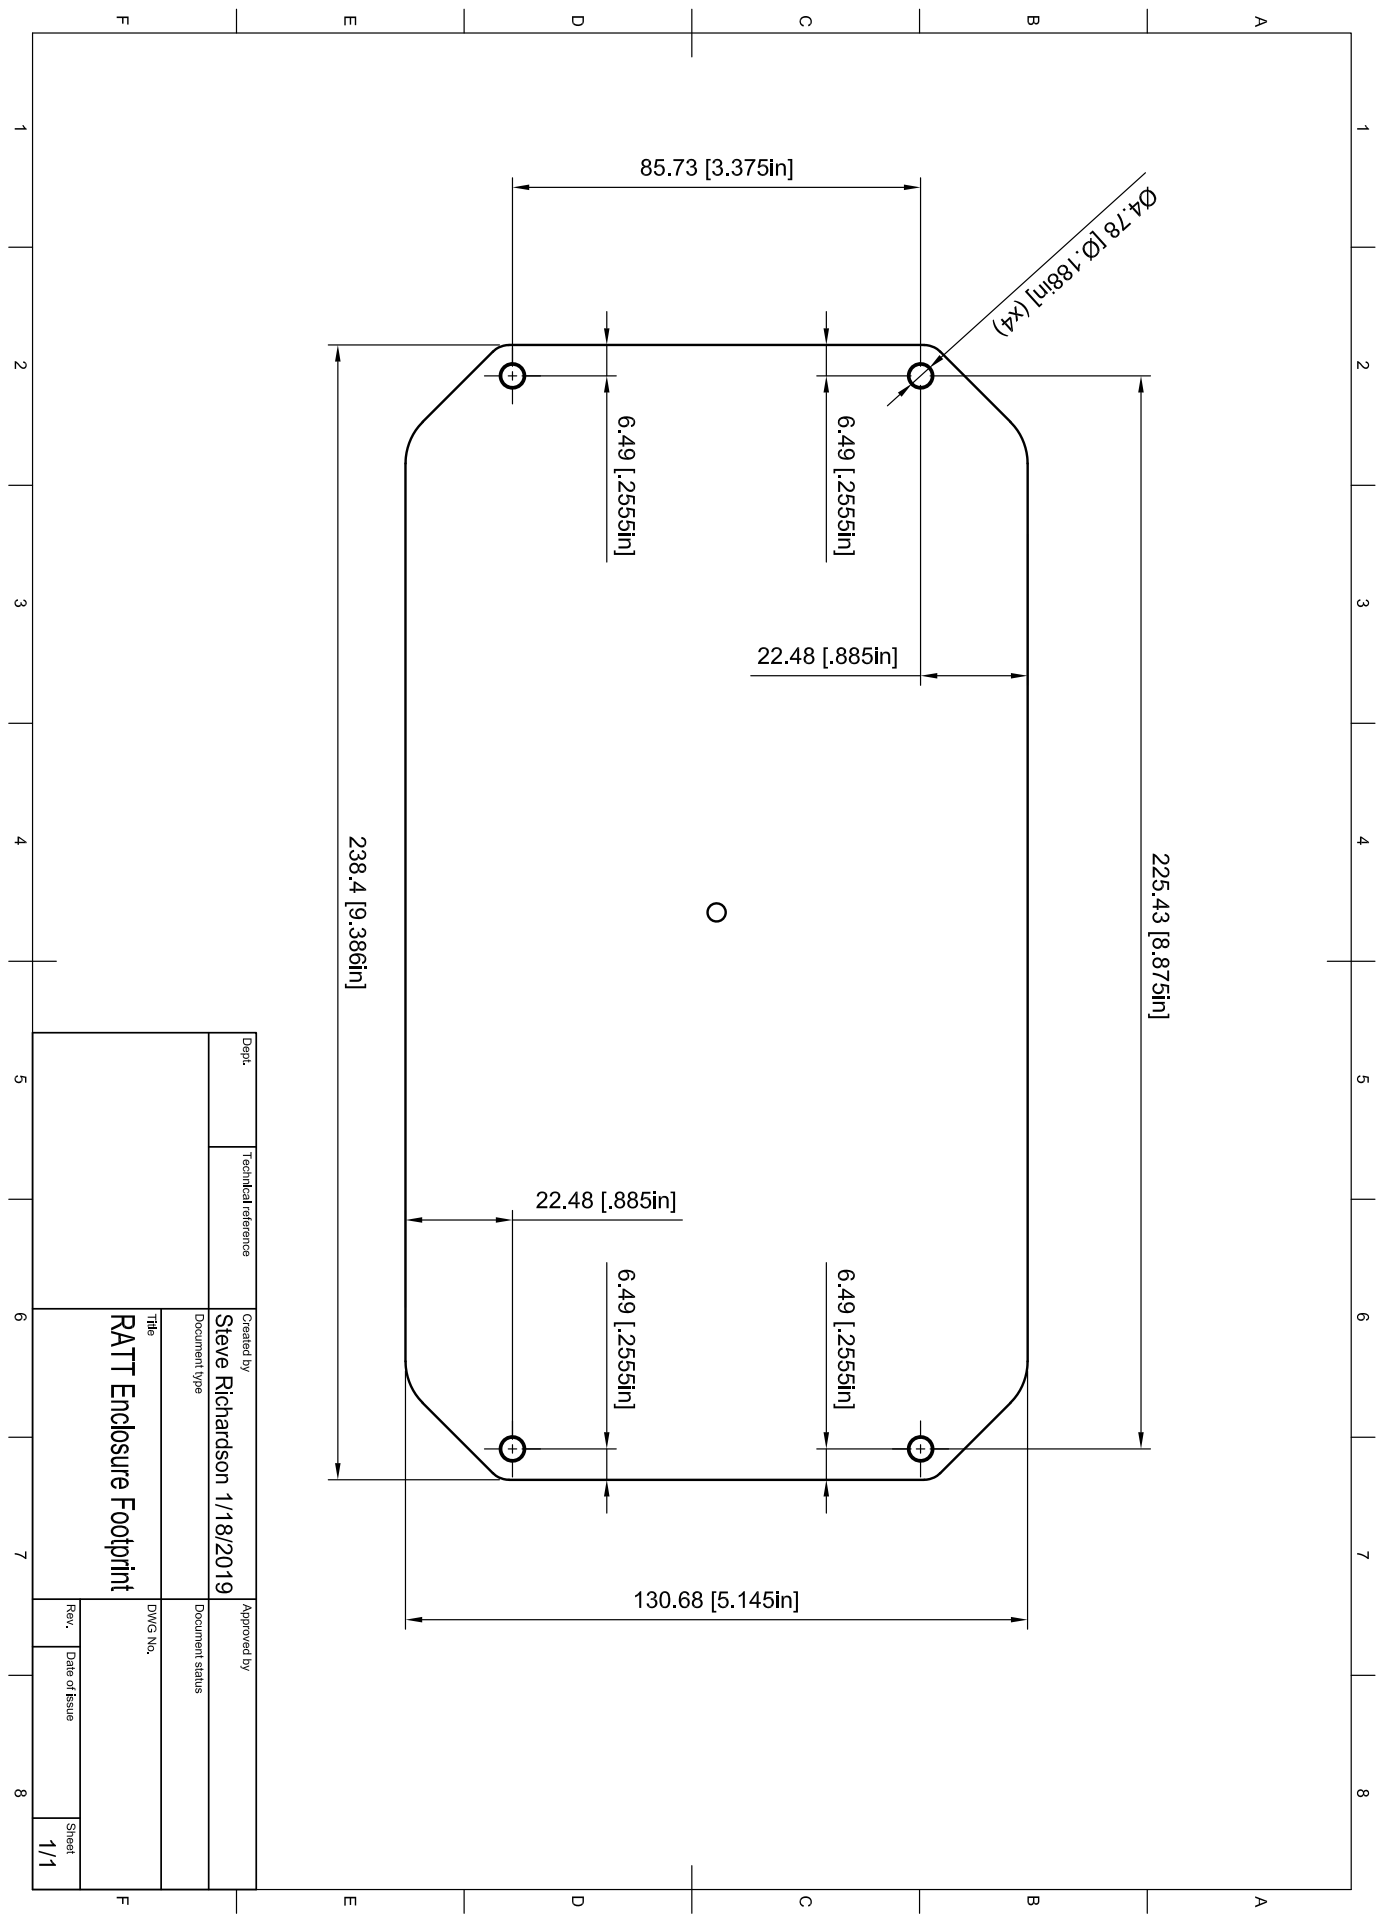
[picture p42: page 1]
