makeitlabs/ratt/integration/MopaLaser/MOPA Wiring.pdf

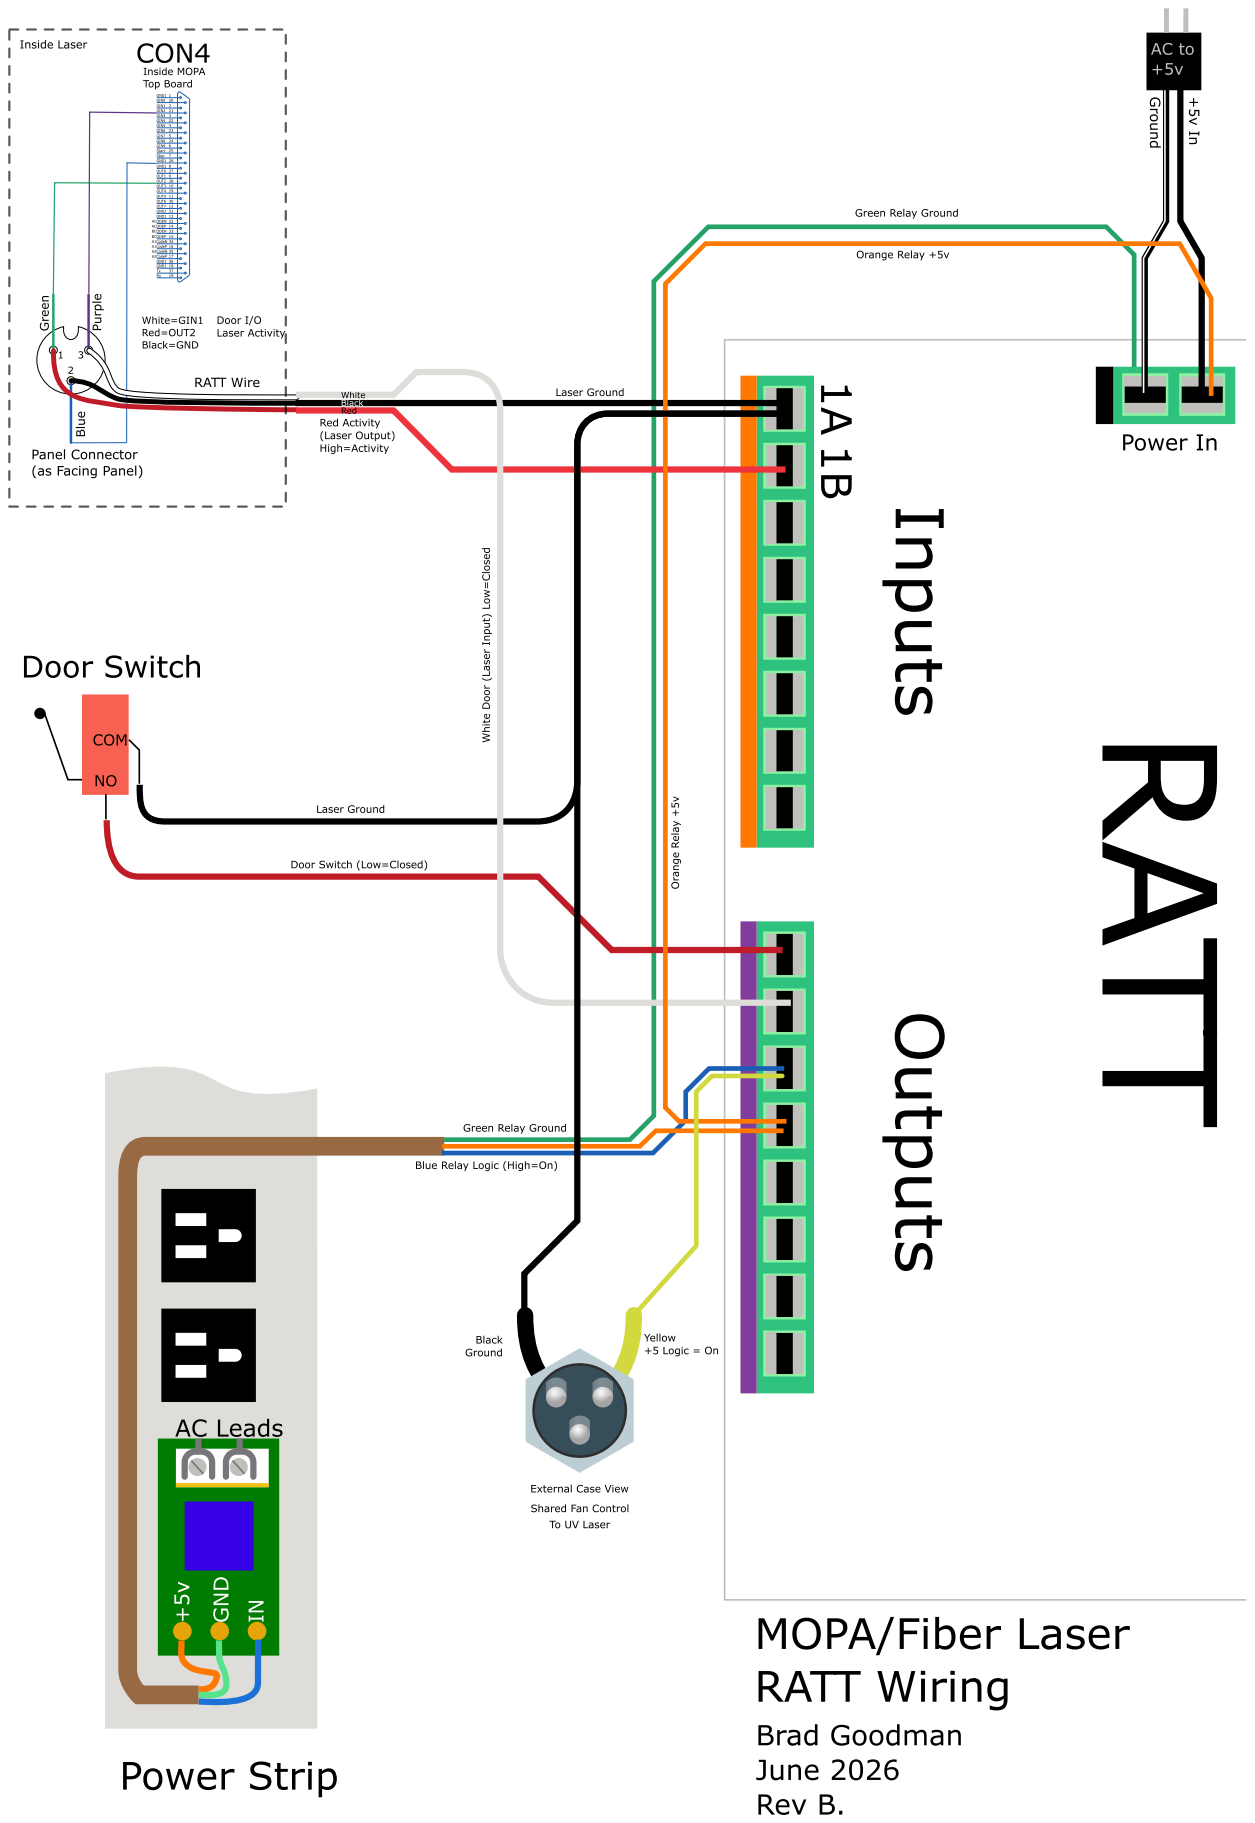
[picture p43: page 1]
