makeitlabs/ratt/integration/AutoLift/mechanical/lift_sensor_target_drawing.pdf

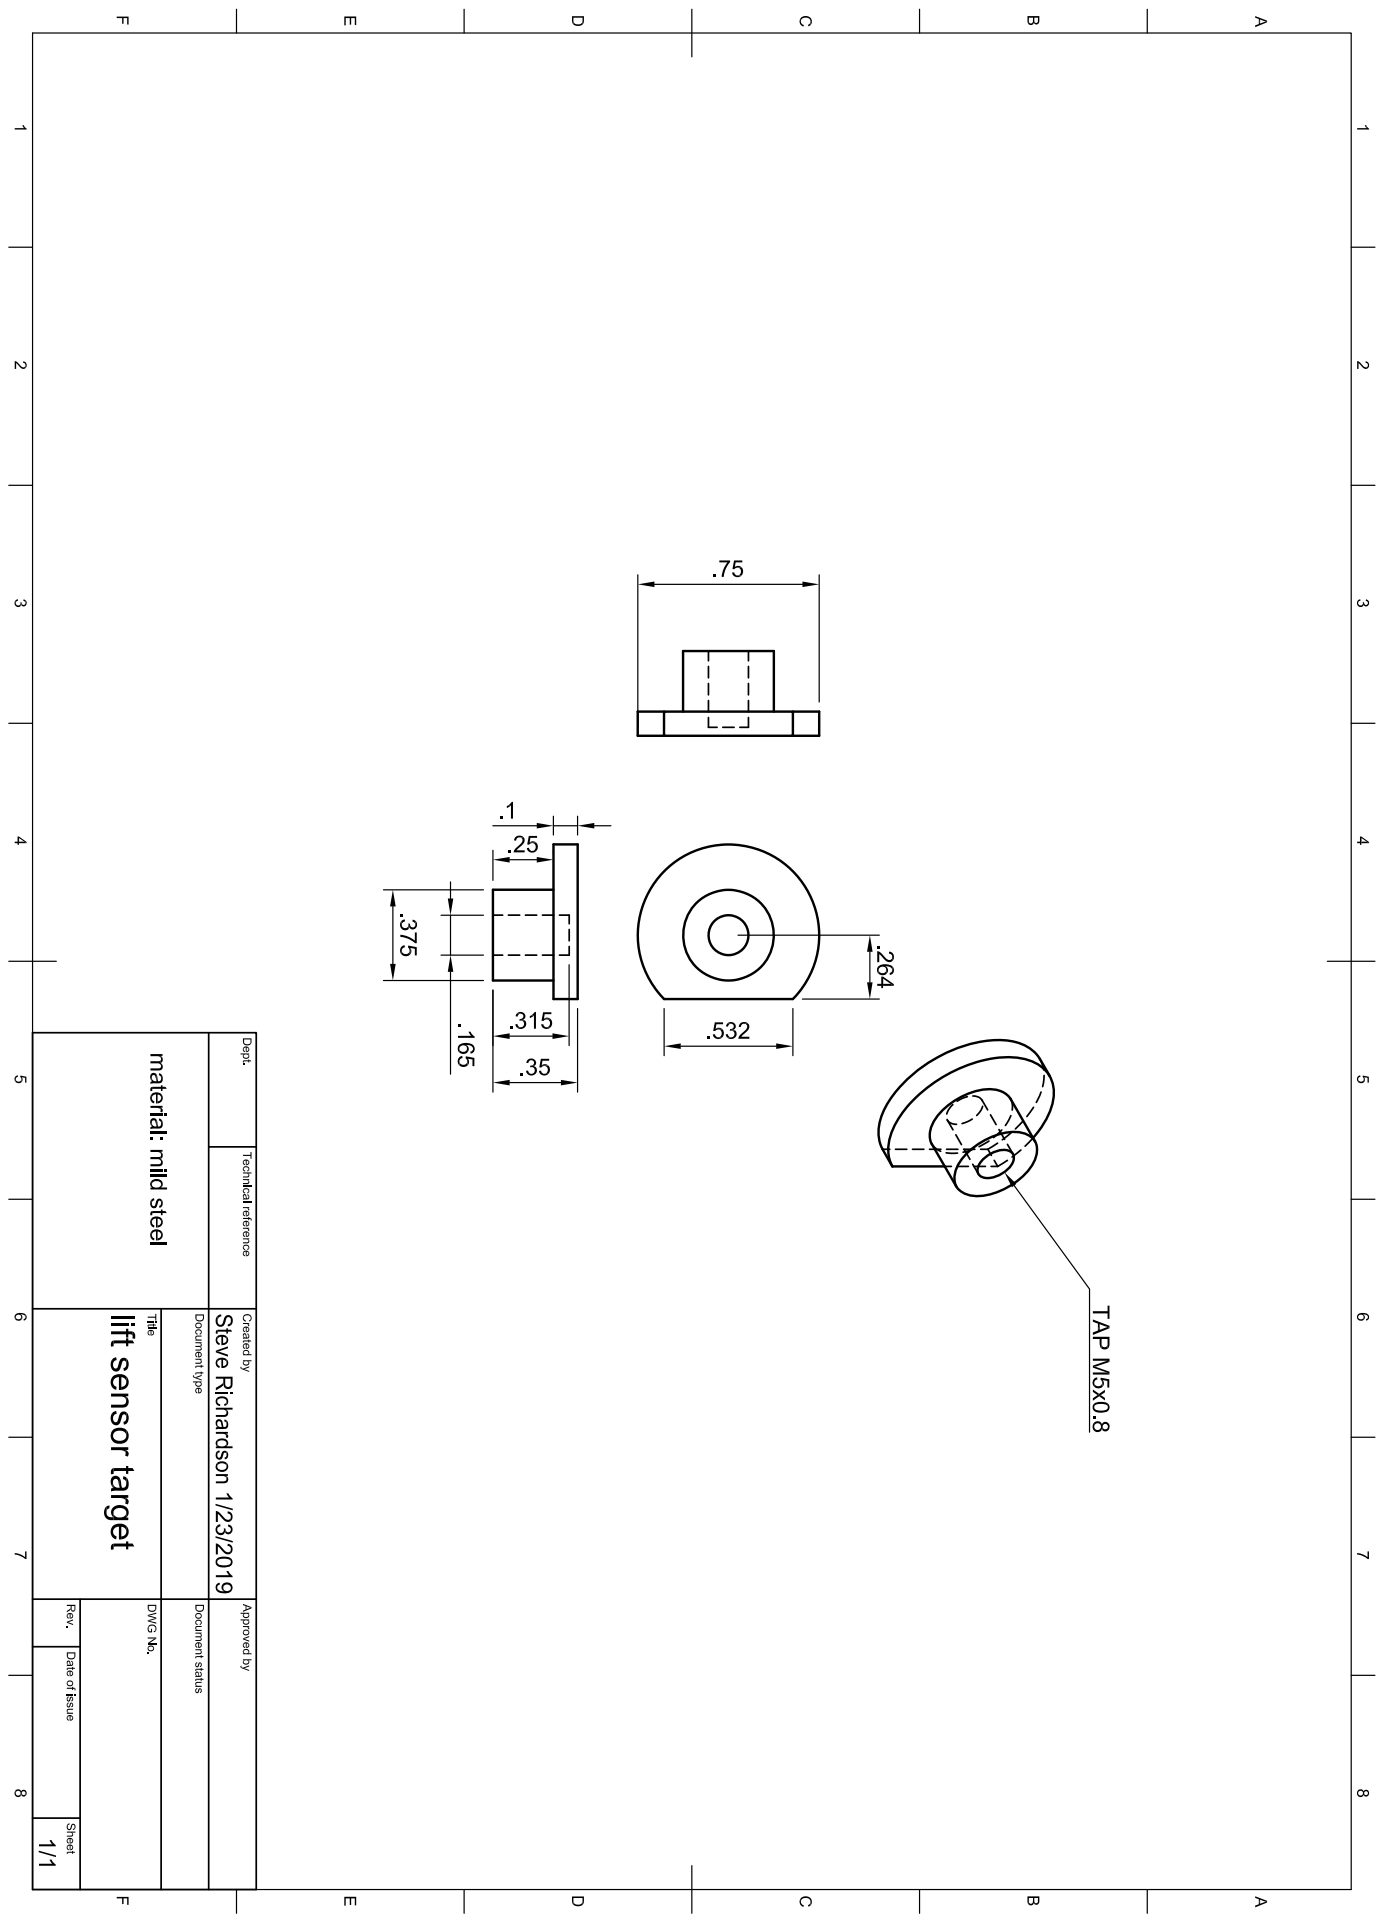
[picture p44: page 1]
