makeitlabs/ratt/hardware/ratt/REV1/assembly/RATT_REV1_assembly_capacitors.pdf

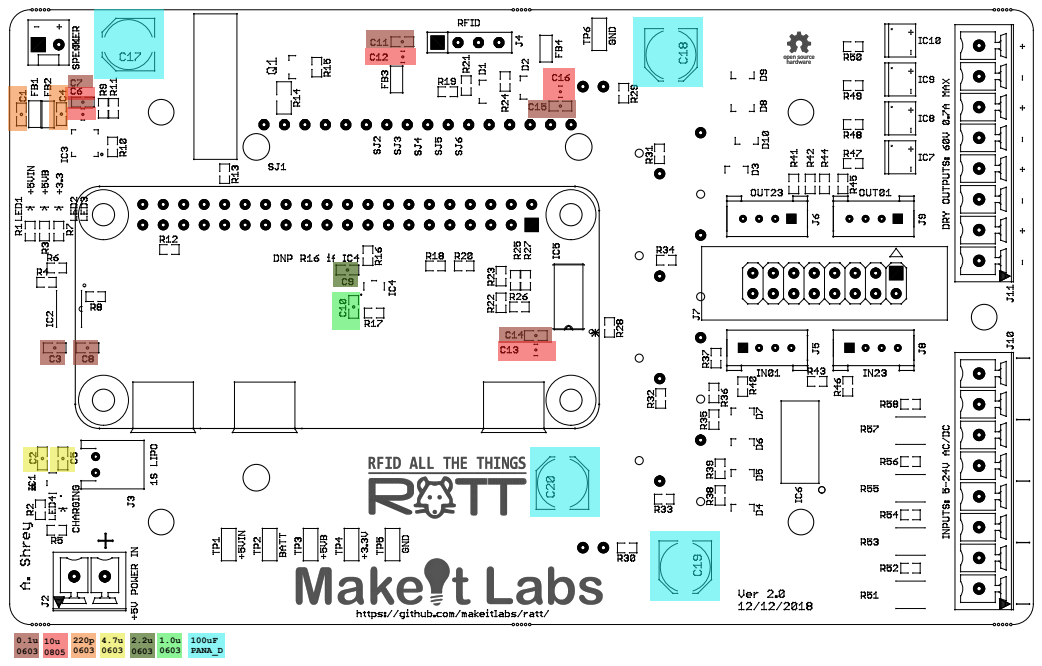
[picture p45: page 1]
100uF PANA_D
