makeitlabs/ratt/integration/EverlastTigWelder/interface_hw/tig_interface_handwired.pdf

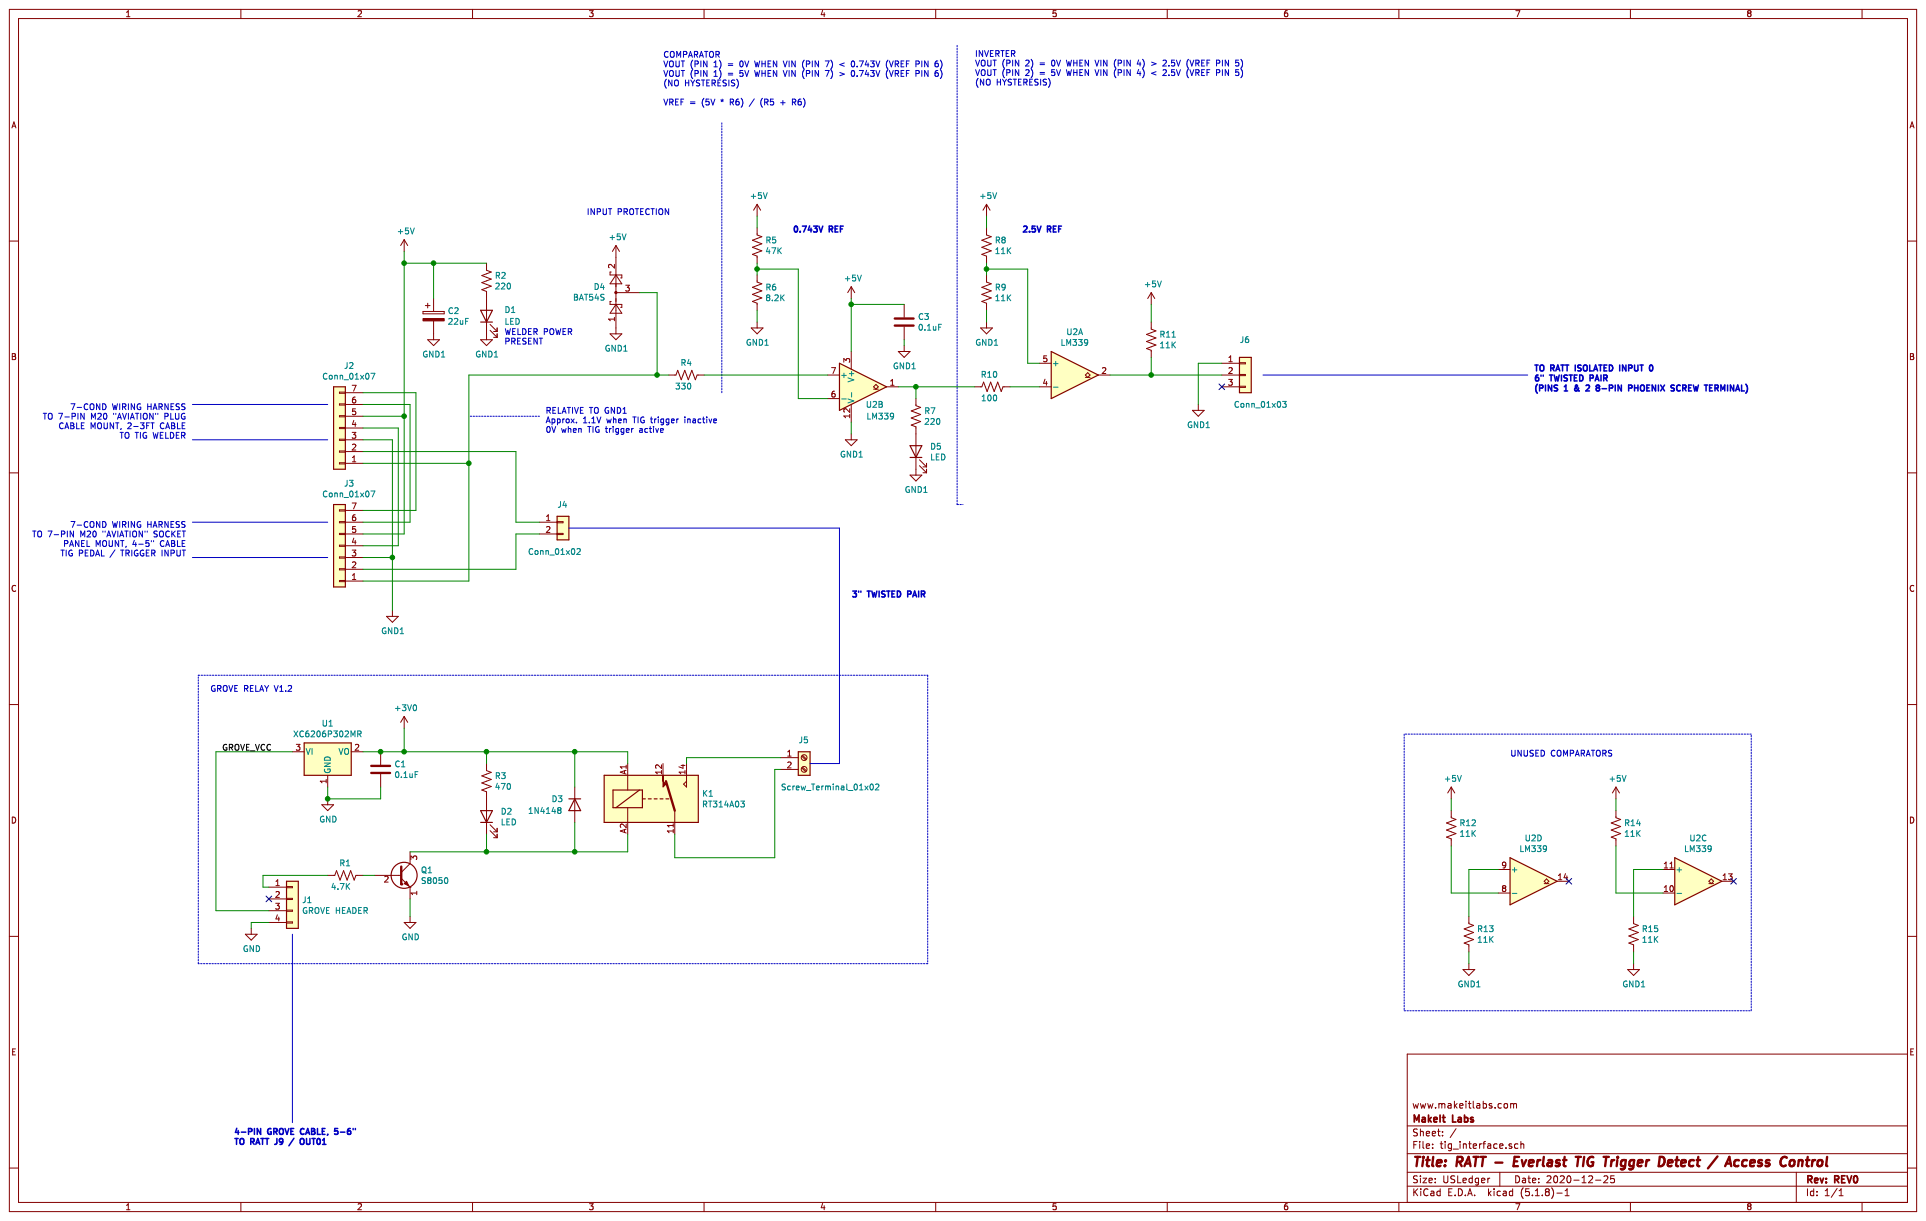
[picture p46: page 1]
