makeitlabs/ratt/hardware/ratt/REV0/assembly/RATT_REV0_assembly_resistors.pdf

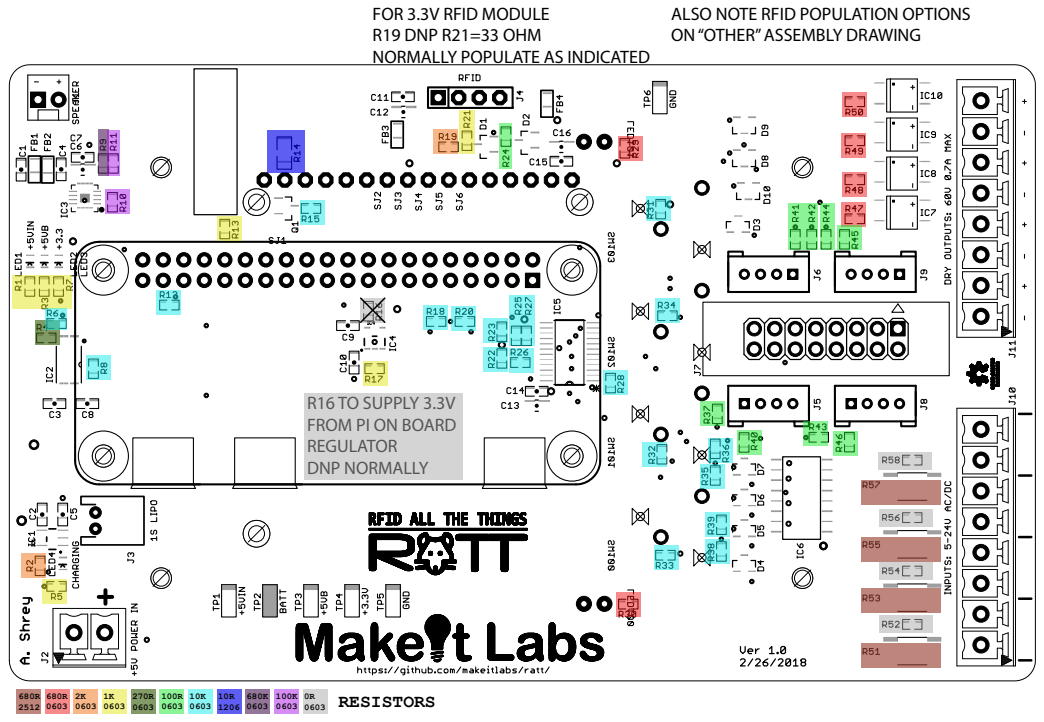
[picture p47: page 1]
RESISTORS

FOR 3.3V RFID MODULE
R19 DNP R21=33 OHM
NORMALLY POPULATE AS INDICATED

ALSO NOTE RFID POPULATION OPTIONS
ON “OTHER” ASSEMBLY DRAWING

R16 TO SUPPLY 3.3V
FROM PI ON BOARD
REGULATOR
DNP NORMALLY
