makeitlabs/ratt/hardware/ratt/REV0/assembly/RATT_REV0_assembly_capacitors.pdf

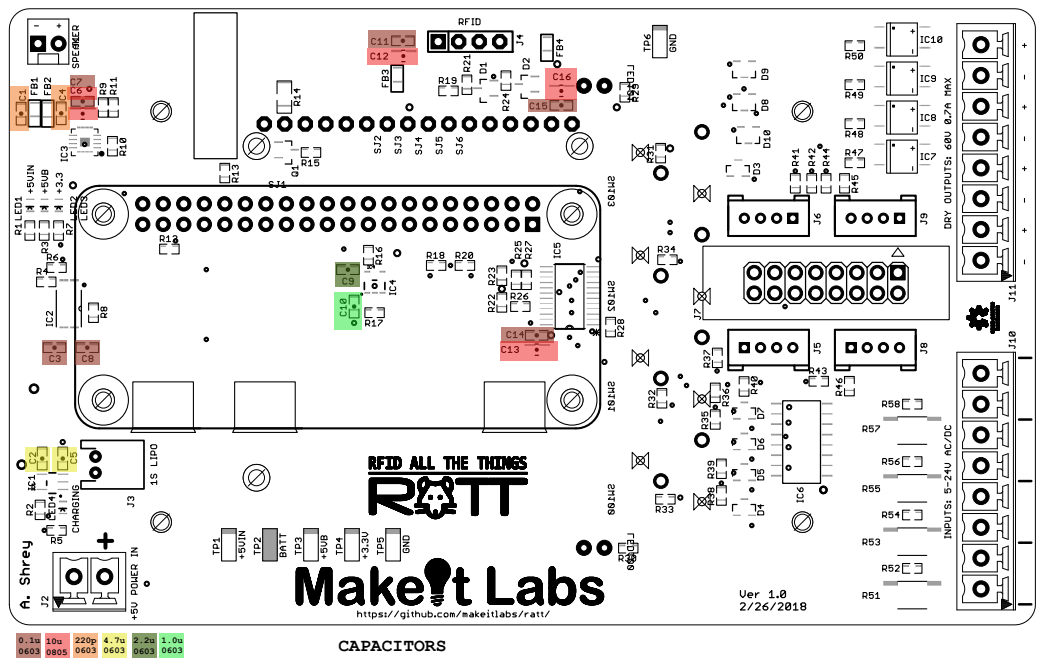
[picture p48: page 1]
CAPACITORS ⁰.1u 0603
