makeitlabs/ratt/firmware/raspbian/boot/config.txt

# For more options and information see
# http://rpf.io/configtxt
# Some settings may impact device functionality. See link above for details

# uncomment if you get no picture on HDMI for a default "safe" mode
hdmi_safe=1

# uncomment this if your display has a black border of unused pixels visible
# and your display can output without overscan
#disable_overscan=1

# uncomment the following to adjust overscan. Use positive numbers if console
# goes off screen, and negative if there is too much border
#overscan_left=16
#overscan_right=16
#overscan_top=16
#overscan_bottom=16

# uncomment to force a console size. By default it will be display's size minus
# overscan.
#framebuffer_width=1280
#framebuffer_height=720

# uncomment if hdmi display is not detected and composite is being output
hdmi_force_hotplug=1

# uncomment to force a specific HDMI mode (this will force VGA)
hdmi_group=2
hdmi_mode=82

# uncomment to force a HDMI mode rather than DVI. This can make audio work in
# DMT (computer monitor) modes
#hdmi_drive=2

# uncomment to increase signal to HDMI, if you have interference, blanking, or
# no display
#config_hdmi_boost=4

# uncomment for composite PAL
#sdtv_mode=2

#uncomment to overclock the arm. 700 MHz is the default.
#arm_freq=800

# reduce gpu memory
gpu_mem=16

# spi lcd
dtparam=spi=on
dtoverlay=ratt-lcd

# i2c expander, i2c bus at 400kHz
# also contains gpio-keys mapping for keypad keys
dtparam=i2c_arm=on
dtparam=i2c_arm_baudrate=400000
dtoverlay=ratt-ioexpander

# i2s audio (from pimoroni/adafruit, need to unwind this to make it our own)
dtparam=i2s=on
dtoverlay=hifiberry-dac
dtoverlay=i2s-mmap

# custom kernel for early boot text and other tweaks
kernel=ratt-kernel.img

# uncomment to enable uart for serial console
# enable_uart=1

# disable bluetooth and restore uart0/ttyAMA0 to GPIO 14/15
dtoverlay=pi3-disable-bt
