makeitlabs/ratt/(commit log)

2017-01-20 adding sample ESP32 console output dump
2017-01-29 porting in HISONA's mbedtls https library - with tweaks required to build on ESP32 - added SSL client certificate support - load certs from flash memory, built by makefile - enforce MBEDTLS_SSL_VERIF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
    [https_client_cert.c]
2017-01-29 switch to ESP malloc routines
2017-02-01 added task to read from uart1 and print received bytes for RFID test.. works.
2017-02-11 work in progress; port/rewrite of adafruit lcd+gfx library with ESP32 DMA SPI routines basic rect, circle, fonts working - needs lots of optimization, more porting work, etc
2017-02-12 stress test stability improvements: add test mutex around all sdcard access, pin all tasks to core 0 continuous audio playback (from SD) + wifi/https (to/from SD) + display (from SD) + RFID
2017-02-18 add i2c peripheral support for PCA9539 16-bit I/O expander demo now writes to I/O expander once per second while the display/audio/RFID/SD card all do their thing
2017-03-04 add timer to net task to send rssi events
2017-03-05 braindead gpio test for four UI buttons on GPIO36-39
2017-03-05 first pass at implementing a RAM frame buffer to eliminate display flicker and improve performance works but net_task() now crashes when it sends a display event.. yet other ones work fine.. need to 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
2017-03-06 bug fixes in frame buffer, seems to fix crashing
2017-03-06 gfx frame buffer can now refresh small regions instead of whole display, more demo tweaks to take advantage of this
2018-01-27 Initial setup from private repo
    Moved RATT hardware files, datasheets, references, etc. into MakeIt Repo
    [Adafruit MAX98357 Breakout.brd, Adafruit MAX98357 Breakout.sch, RATT_REV0.brd, RATT_REV0.dxf, RATT_REV0.sch, esp32-thing.brd, esp32-thing.sch, jdt1800-bob.brd]
2018-01-27 Minor chanages while planing
    Pi Zero library symbol added, references added
    [LiPo Rider Pro v0.9b.brd, LiPo Rider Pro v0.9b.sch, LiPo Rider.brd, LiPo Rider.sch, RATT_REV0.sch]
2018-01-29 pushing in working device tree overlays and configs for pi zero w prototype
    [config.txt]
2018-01-29 add i2s audio setup script from adafruit/pimoroni. this needs to be decomposed into device tree and other changes at some point.
2018-01-29 add quick qt5 + keypad test, direct framebuffer qt rendering (no X11/Wayland) and key events are standard linux system key events
2018-01-31 Bye bye ESP, hello pi
    Removed all the old ESP stuff, added some power path stuff, conencted nets to the pi pins renaming as needed. Mucho cleanup needed.
    [RATT_REV0.brd]
2018-01-31 Forgot to save first
    derp
    [RATT_REV0.brd, RATT_REV0.sch]
2018-01-31 very early work starting to piece together app framework based on PyQt5. this has a functional SSL-based ACL downloader with working client and server certs (two-way auth). similar to (but less crust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
2018-02-04 tweaks to config.txt for keypad moving to i/o expander, and enabling uart for rfid
    [config.txt]
2018-02-05 remove QWidget based PyQt test framework
2018-02-09 new display, buttons moved
    Added chinafruit 2.0, moved buttons to i/o expander, added i/o lines to expander
    [RATT_REV0.brd, RATT_REV0.sch]
2018-02-10 Optos added, cleaning
    Added optos to the inputs, cleaned up the schematic a little.
    [RATT_REV0.brd]
2018-02-11 Added MakeItLabs library
    Renamed version of Paul's makeitlabsv7.lbr, added my own generic resistor, capacitor, a a few other useful misc parts.
2018-02-12 All sorts of shit
    I/Os are done, connectors, protections, options all added. Screen updated, library updated, very close to layout ready.
    [RATT_REV0.brd, RATT_REV0.sch]
2018-02-12 add yocto build and submodules for yocto poky-rocko, hopefully didn't break it too badly
    [templateconf.cfg]
2018-02-17 Stuff we done
    stuff I did Thursday and didn't commit
    [RATT_REV0.brd, RATT_REV0.sch]
2018-02-18 saturday ratt
    [RATT_REV0.brd, RATT_REV0.dxf, RATT_REV0.sch]
2018-02-18 psuedo-routing
    psuedo-routing to figure out final routing plan
    [RATT_REV0.brd, RATT_REV0.sch]
2018-02-20 Lots o' routing
    Screen, Pi, audio, preliminary IO routed
    [RATT_REV0.brd, RATT_REV0.sch]
2018-02-23 Lot's O' routin'
    Board resized to 3x5"
    I/O 100% placed and routed
    LEDs placed and routed
    I/O chip routed
    Todo: Power stuff
    [RATT_REV0.brd, RATT_REV0.sch]
2018-02-23 Fixed some derps
    Routed through a few mounting areas, fixed that.
    Removed file name from the imported bmp files in the library and on the board
    [RATT_REV0.brd, RATT_REV0.sch]
2018-02-23 Ran DRC, fixed stuff
    Ran a DRC on existing routing and fixed critical errors
    [RATT_REV0.brd]
2018-02-23 A few tweaks on sch and brd
    added PU to unused IO, added caps and beads to RFID power lines
    [RATT_REV0.brd, RATT_REV0.sch]
2018-02-24 Just need to do the dumb power path
    I forget what I did, but it wasn't the power path yet
    [RATT_REV0.brd, RATT_REV0.sch]
2018-02-24 Renamed Power Supply Nets
    +5VIN = Input from Dc brick
    +5VB = 5V or Battery backed supply
    +3.3V = +3.3V supply created from +5VB by either Pi or reg circuit
    [RATT_REV0.brd, RATT_REV0.sch]
2018-02-24 Schematic Done! (ref des and attributes may change)
    Initial pass on schematic done. Ref Des and attributes will change before it is finished though
    [RATT_REV0.brd, RATT_REV0.sch]
2018-02-24 Moved all parts into MakeItLabs Library
    [RATT_REV0.brd, RATT_REV0.sch]
2018-02-24 most stuff placed
    [RATT_REV0.brd, RATT_REV0.sch]
2018-02-25 Added some stuff
    Added clamps to RFID, added 1206 series resistor to LCD backlight
    power in connector updated
    lipo connector moved
    played with cut away of plane
    [RATT_REV0.brd, RATT_REV0.sch]
2018-02-25 moved stuff for Steve
    [RATT_REV0.brd, RATT_REV0.sch]
2018-02-25 minor tweak
    [RATT_REV0.brd]
2018-02-25 Added Test Points, GND Vias
    [RATT_REV0.brd, RATT_REV0.sch]
2018-02-26 Silkscreen
    RefDes adjusted and normalized, text added, parts renumbered
    [RATT_REV0.brd, RATT_REV0.sch]
2018-02-26 fixed button footprints to correct DRC issues
    [RATT_REV0.brd, RATT_REV0.sch]
2018-02-26 CAM run and fab files created
    [RATT_REV0.drills.xln]
2018-02-26 Flipped speaker connector, Added logo and other silkscreen, hipstered corners
    [RATT_REV0.brd, RATT_REV0.sch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]
2018-02-26 forgot to delete text off to side
    [RATT_REV0.brd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]
2018-03-02 cleanups and tweaks and tightening, added a timer facility, commit before more major reorg
2018-03-02 split off actual state machine from the underlying PersonalityBase framework junk
2018-03-03 cleaning up and tightening wake enable/disables
2018-03-03 switch comment style of original code to #
2018-03-03 restructuring- moved rfid slot and active member record into personality base
2018-03-03 bunch of work to get issue reporting roughed in.. doesn't report anything yet but the UI flow is there
2018-03-05 add assembly drawings
2018-03-05 add pi and display standoff STL models for 3d printing
    [RATT_TOP0.dxf, display_standoff.stl, pi_standoff_1.stl, pi_standoff_2.stl]
2018-03-06 fix & clarify assembly drawings
2018-03-10 initial work for power and charge status monitoring with new wake events this may have exposed a race condition or other bug in the qtgpio stuff that needs exploring (occasionally misses loss events 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
2018-03-10 more power loss work
2018-03-10 countdown on shutdown screen, de-init gpio, actually kick off system shutdown
2018-03-11 housekeeping to split off personality state machine and thread code from personality base
2018-03-11 split gpio pin containers into in/out for clarity
2018-03-11 implement idle and active timers, idle timeout and flashy display
2018-03-13 add in front panel LED support
2018-11-13 moving old ESP32 stuff to the attic
2018-11-26 front panel LED pattern when in lockout mode, exit lockout state cleanup
2018-11-26 rework mqtt path again to provide status and control paths, wire up wifi status as first example periodic status
2018-11-29 moving cert generating junk from the old ESP32 days since it'll be a useful starting point
2018-12-02 created 'integration' dir, add documented full spectrum laser arduino glue logic project
2018-12-02 add wiring diagram for full spectrum integration
2018-12-02 fix a couple minor things in the diagrams
2018-12-02 move the mqtt stuff into a thread to avoid blocking behavior on connections. also adds broker connect/disconnect signal and personality base will now broadcast state on mqtt when reconnecting
2018-12-02 add more mqtt telemetry for manual/timeout logout, usage tracking, lockout status, system power loss/restoration/shutdown, issue reporting
2018-12-03 add pdf of schematic to hw dir
2018-12-04 hack to constantly play silence audio, to eliminate pops and clicks of amplifier/dac due to power-up/power-down
2018-12-04 if iwconfig returns 'No such device' make some simulated wifi status for simulator
2018-12-05 basic functionality on simulated input pins, rework the sim i/o signal/slots to use names instead of numbers
2018-12-05 initial stab at creating a personality inherited from Simple, so far it just controls a couple settings and does not override states
2018-12-05 add optional power monitoring to PersonalitySimple, make safety check optional in same, a bunch of new work on the idle view
2018-12-06 wrote a nicer version of my sd card loop filesystem mounting script to manipulate sdimg on devhost filesystem
2018-12-06 adding a sample fstab for mounting dev host directory for rapid development
2018-12-07 Create Bottom Half Plate for Arduino Screw Terminal Breakout.dxf
    [Bottom Half Plate for Arduino Screw Terminal Breakout.dxf]
2018-12-07 fix holes
    [Bottom Half Plate for Arduino Screw Terminal Breakout.dxf]
2018-12-08 rework how the paho event loop is called in the mqtt thread
2018-12-08 adds MQTT.NodeId config option that will override using the mac addr, adds General.NetworkInterfaceName to allow setting network device
2018-12-08 allow configurable tool lockout states in personality state machine, use this to allow PersonalitySimple to lock out tool when in idle state OR when tool is not powered
2018-12-08 add TOOL_ENABLED_NOT_POWERED state to better handle exiting active state when tool power lost, generates mqtt logout msg with 'toolpower' reason, play logout sound effect
2018-12-11 add "not powered denied" state to provide feedback when scanning RFID when the tool is not powered up
2018-12-11 better rfid logo more consistent with enclosure artwork to guide user to swipe in the right place
2018-12-11 fix where power on is reported via mqtt in the powered down state, fixes bug with erroneous power on message when going to lockout state from powered off state
2018-12-13 Made Rev1, most changes implemented
    [BoardBOM.xlsx, RATT_REV0.brd, RATT_REV0.csv, RATT_REV1.brd, RATT_REV1.sch]
2018-12-14 REV1 as sent out to fab
    [RATT_REV1.brd, RATT_REV1.sch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]
2018-12-14 housekeeping on hardware design files, phase 1
    [BoardBOM.xlsx, RATT_REV0.brd, RATT_REV0.csv, RATT_REV0.dxf, RATT_REV0.sch, RATT_REV1.brd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]
2018-12-14 yet another reorg, structured with revision at the root and broken out to eagle, fab and assembly within each rev
    [BoardBOM.xlsx, RATT_REV0.brd, RATT_REV0.csv, RATT_REV0.dxf, RATT_REV0.sch, RATT_REV1.brd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]
2018-12-21 adding REV1 (aka version 2) assembly drawings/PDF schematic/DXF outline
2018-12-29 created parts sheet for hand assembly of boards
2018-12-31 fix missing C15 on assembly drawing
2018-12-31 updated STL models for pi standoff, display standoff, and speaker resonator
    [display_standoff.stl, pi_standoff_1.stl, pi_standoff_2.stl, speaker_resonator.stl]
2019-01-11 add lift integration wiring documentation
2019-01-18 add enclosure footprint dxf, pdf drawing, and datasheets from Polycase
    [RATT_Enclosure_Footprint.dxf]
2019-01-19 initial implementation of homing sequence in place of safety check for laser cutter
2019-01-19 for homing: add speech audio prompts, improved nagging, a bunch of other tweaks
2019-01-19 exit homing state if tool powered off
2019-01-19 add 60 sec timeout timer to wait for homing
2019-01-19 only require homing after tool has been turned off
2019-01-19 add optional external homing override for possible integration with rotary tool (on input 4). also makes manual override optionally available.
2019-01-23 adding auto lift wiring documentation and sensor bracket STL files, adding Rabbit laser wiring documentation
    [clamp_lower1.stl, clamp_lower2.stl, clamp_upper1.stl, clamp_upper2.stl]
2019-01-31 adding B.O.I. (Big Obnoxious Indicator) mech files
    [indicator_acrylic_3mm.dxf, indicator_bottom.stl, indicator_separator.stl, indicator_top.stl]
2019-02-02 change logic on laser homing override
2019-02-02 add Arduino project for RGB LED indicator
2019-02-04 Adds new feature, if Personality.AllowForcedLogout=True, long-press on ESC during tool active will force a logout with mqtt reason=forced (stopgap for flaky lift sensor)
2019-02-07 rework threading in serial output code for B.O.I., use a queue and only deal with port i/o in worker thread.. seems to fix RFID reading regression
2019-02-16 fix a couple of regressions when running in non-sim gpio mode
2019-03-18 start of RATT Doorbot hardware for Pi3 B+
    [doorbot.kicad_pcb, doorbot.sch]
2019-03-18 more doorbot schematic & pcb work
    [doorbot.kicad_pcb, doorbot.sch]
2019-03-19 moar doorbot pcb
    [doorbot.kicad_pcb, doorbot.sch]
2019-03-19 doorbot: add dc boost for 24v option, PTC fuse
    [doorbot.kicad_pcb, doorbot.sch]
2019-03-21 more doorbot schematic & pcb, routed and passes drc but not complete
    [clamp_lower_sensor_12mm.stl, doorbot.kicad_pcb, doorbot.sch, led_strip_bulkhead1.stl, led_strip_bulkhead2.stl, led_strip_bulkhead3.stl, led_strip_bulkhead4.stl]
2019-03-21 add a couple 3d models
    [doorbot.kicad_pcb]
2019-03-21 add wiegand led/buzzer control, leds, some rerouting
    [doorbot.kicad_pcb, doorbot.sch]
2019-03-22 more doorbot pcb work
    [doorbot.kicad_pcb, doorbot.sch]
2019-03-22 doorbot pcb rev0 draft 2 ready for review
    [doorbot.kicad_pcb, doorbot.sch]
2019-03-23 3d models
    [3269P.stp, 4_PIN_SSOP.STEP, CAP_EEE_A.step, D8.step, ESQ-102-24-G-D.stp, ESQ-120-24-T-D.stp, SOT-89.step, User Library-grove v1.step]
2019-03-23 move duty cycle pot, try to fix mickey mouse corners on cutout
    [doorbot.kicad_pcb]
2019-03-23 add atmega reset pullup & AREF cap, fix footprint library issue, small tweaks & cleanup, ready for fab
    [doorbot.kicad_pcb, doorbot.sch]
2019-03-23 fabrication files
    [doorbot-B_Cu.gbr, doorbot-B_Mask.gbr, doorbot-B_Paste.gbr, doorbot-B_SilkS.gbr, doorbot-Edge_Cuts.gbr, doorbot-F_Cu.gbr, doorbot-F_Mask.gbr, doorbot-F_Paste.gbr]
2019-03-23 add .step model and board renders
2019-03-23 update placeholder resistors with calculated values
    [doorbot.sch]
2019-03-23 add pdf schematic and bom to assembly directory
    [doorbot bom.csv]
2019-03-24 add new current sensor prototype schematic & pcb prototype - already sent off to fab!
    [AC1015.step, User Library-grove v1.step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]
2019-03-26 add current sense firmware for ATTiny85 (Arduino env)
2019-03-26 add some more info on attin85/arduino env
2019-03-26 a few schematic value tweaks and adds bom for current sensor board
    [current_sense.sch, current_sense_bom.csv]
2019-03-29 adds button press (blue/enter) to reset idle timer when logged in - issue #6
2019-03-29 adds visual indicator to suggest pressing blue button when timeout happens
2019-03-31 add assembly drawings for doorbot
2019-03-31 rename a couple doorbot assembly files
    [doorbot_REV0_bom.csv]
2019-03-31 add current sense schematic pdf and assembly drawing
    [isense_REV0_bom.csv]
2019-04-03 start of softserial-based calibration routine for current sensor
2019-04-19 fixes one instance where the beep alert for laser homing would start when exiting from homing (yel button) when the speech help was playing
2019-04-28 somehow lost the laser cutter personality changes which actually enabled the tool...
2020-02-04 - ARM/ARMs can log-into locked-out resources - "Lockout" messages displays "message" (not JSON payload) - Admin timeout value works (used normal timeout before) - Laser ARMs/RMs can use blue button t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
2020-10-06 remove a couple of brad's debug prints
2020-11-26 Pulling the 4-year-old ESP32 stuff out of the attic.
2020-11-26 work in progress to port the circa Jan.2017 ESP32 RATT code to modern 2020 ESP-IDF
2020-12-04 add beeper task, temporary hacks in rfid to actuate motor driver (will move to own task)
2020-12-06 create door motor task, remove temp crap from rfid task
2020-12-12 WIP uratt KiCad schematic
    Start of the new ESP32 uRATT schematic
    [uratt.kicad_pcb, uratt.sch]
2020-12-12 add force ACL download feature in idle loop, long press on down button
2020-12-14 more schematic work.. power supply, lip charger, etc
    more schematic work.. power supply, lip charger, etc
    [uratt.sch]
2020-12-16 mostly feature complete schematic?
    Split off pages for power and front panel, assign all I/O, add alarm & exp, add 10V option off 5V boost for optional stepper driver (for cabinet lock-bot), ESD protection
    [uratt-frontpanel.sch, uratt-power.sch, uratt.sch]
2020-12-17 uRATT rough footprint assignment and placement for fitment
    [uratt-frontpanel.sch, uratt-power.sch, uratt.kicad_pcb, uratt.sch]
2020-12-18 import actual board outline DXF and adjust rough placement
    [uratt-frontpanel.sch, uratt.kicad_pcb, uratt.sch]
2020-12-21 WIP routing
    [uratt-frontpanel.sch, uratt-power.sch, uratt.kicad_pcb, uratt.sch]
2020-12-22 fully routed, DRC'd, outlined w/breakaways, pending final review
    [uratt-frontpanel.sch, uratt-power.sch, uratt.kicad_pcb, uratt.sch]
2020-12-22 add wire passthru slot, move & finalize flat flex, bigger fp button, 10V option for motor, exp connector now Grove with I2C option
    [uratt-frontpanel.sch, uratt-power.sch, uratt.sch]
2020-12-22 add rev0 fabrication files - pcb sent off to fab
    [uratt-B_Cu.gbl, uratt-B_Mask.gbs, uratt-B_Paste.gbp, uratt-B_SilkS.gbo, uratt-Edge_Cuts.gm1, uratt-F_Cu.gtl, uratt-F_Mask.gts, uratt-F_Paste.gtp]
2020-12-24 completed BOM, 3D STEP export
    [uratt-frontpanel.sch, uratt-power.sch, uratt.sch, uratt_rev0_bom.csv]
2020-12-24 move uratt hw design into REV0 directory, add kicad backup files to git ignore list
    [uratt-B_Cu.gbl, uratt-B_Mask.gbs, uratt-B_Paste.gbp, uratt-B_SilkS.gbo, uratt-Edge_Cuts.gm1, uratt-F_Cu.gtl, uratt-F_Mask.gts, uratt-F_Paste.gtp]
2020-12-24 clean up old "load" hw project which didn't really exist, rename "logic" hw project to "ratt"
    [BoardBOM.xlsx, RATT_REV0.brd, RATT_REV0.csv, RATT_REV0.dxf, RATT_REV0.sch, RATT_REV1.brd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]
2020-12-24 move RATT eagle library and Adam's random references directory into the RATT subproject
    [Adafruit MAX98357 Breakout.brd, Adafruit MAX98357 Breakout.sch, LiPo Rider Pro v0.9b.brd, LiPo Rider Pro v0.9b.sch, LiPo Rider.brd, LiPo Rider.sch, esp32-thing.brd, esp32-thing.sch]
2020-12-24 add logo DXFs
    [MakeIt Labs Logo 2016.dxf, ratt logo.dxf]
2020-12-24 current sensor project, fuse bit notes comment
2020-12-24 add prelim doorbot alphanumeric I2C LCD project (stalled work in progress)
    [doorbot_lcd.kicad_pcb, doorbot_lcd.sch]
2020-12-27 add 3D models to uratt
    [1-1734839-0.stp, 1051330001.stp, CUI_DEVICES_CPT-9019S-SMT-TR.step, ER-TFT0.96-1 Footprint v13.step, Grove Connector (standing).STEP, User Library-CDRH124_Sumida.step, User Library-KSC241J.STEP, User Library-Micro SD Card.step]
2020-12-27 add tig interface schematic
    [tig_interface.kicad_pcb, tig_interface.sch]
2020-12-31 add interactive BoM for assembly
2021-01-01 work in progress porting to REV0 board
2021-01-02 add front panel button test
2021-01-09 cleanup, button test
2021-01-10 add REV0 ECO list. start REV1 (copy of REV0)
    [1-1734839-0.stp, 1051330001.stp, CUI_DEVICES_CPT-9019S-SMT-TR.step, ER-TFT0.96-1 Footprint v13.step, Grove Connector (standing).STEP, User Library-CDRH124_Sumida.step, User Library-KSC241J.STEP, User Library-Micro SD Card.step]
2021-01-10 Add handwired TIG interface schematic PDF
2021-01-11 add REV0 schematic PDF
2021-01-11 work in progress on REV1 schematic/PCB
    [uratt-frontpanel.sch, uratt-power.sch, uratt.kicad_pcb, uratt.sch]
2021-01-12 split uratt REV1 front panel to separate kicad project (for 2 layer board)
    [uratt_fp.kicad_pcb, uratt_fp.sch]
2021-01-12 uratt REV1 work, remove front panel, place new parts, partial routing
    [uratt-frontpanel.sch, uratt-power.sch, uratt.kicad_pcb, uratt.sch]
2021-01-12 Add RATT REV1 BOM (bare CSV file straight from Eagle, grouped by REFDES)
    [RATT_REV1_BOM.csv]
2021-01-13 uRATT REV1 progress. placed and mostly routed.
    [RATT_REV1_BOM.ods, c-1-1734742-0-o-3d.stp, uratt-power.sch, uratt.kicad_pcb]
2021-01-13 passes drc
    [uratt.kicad_pcb]
2021-01-14 complete relayout of 5V boost switcher, add plated mount holes w/FB GND ties, passes DRC
    [uratt-power.sch, uratt.kicad_pcb]
2021-01-14 add breakaway rails & fiducials for assembly
    [uratt.kicad_pcb, uratt.sch]
2021-01-16 separate front panel board layout
    [CUI_DEVICES_CPT-9019S-SMT-TR.step, ER-TFT0.96-1 Footprint v13.step, User Library-KSC241J.STEP, c-1-1734742-0-o-3d.stp, uratt_fp.kicad_pcb, uratt_fp.sch]
2021-01-16 uratt fp, add rails, fiducials, alt speaker option, cap, nearly ready for fab
    [CUI_DEVICES_CVS-1508.step, uratt_fp.kicad_pcb, uratt_fp.sch]
2021-01-16 uratt REV1 change inductor, cleanups, add 3.3V motor option, silk work, 12 pin FFC
    [1-1734742-2.stp, IND_BOURNS_SRR6603.step, srr6603.stp, uratt-power.sch, uratt.kicad_pcb, uratt.sch]
2021-01-16 change front panel to 12 pin
    [1-1734742-2.stp, uratt_fp.kicad_pcb, uratt_fp.sch]
2021-01-16 generate fab files for uratt and uratt_fp
    [uratt-B_Cu.gbl, uratt-B_Mask.gbs, uratt-B_Paste.gbp, uratt-B_SilkS.gbo, uratt-Edge_Cuts.gm1, uratt-F_Cu.gtl, uratt-F_Mask.gts, uratt-F_Paste.gtp]
2021-11-24 prepare uratt for moving to new repo
    [1-1734742-2.stp, 1-1734839-0.stp, 1051330001.stp, CUI_DEVICES_CPT-9019S-SMT-TR.step, CUI_DEVICES_CVS-1508.step, ER-TFT0.96-1 Footprint v13.step, Grove Connector (standing).STEP, IND_BOURNS_SRR6603.step]
2021-11-24 uratt now moved to its own repo
    [1-1734742-2.stp, 1-1734839-0.stp, 1051330001.stp, CUI_DEVICES_CPT-9019S-SMT-TR.step, CUI_DEVICES_CVS-1508.step, ER-TFT0.96-1 Footprint v13.step, Grove Connector (standing).STEP, IND_BOURNS_SRR6603.step]
2021-11-24 prep for doorbot split
    [3269P.stp, 4_PIN_SSOP.STEP, CAP_EEE_A.step, D8.step, ESQ-102-24-G-D.stp, ESQ-120-24-T-D.stp, SOT-89.step, User Library-grove v1.step]
2021-11-24 move doorbot hardware projects to doorbot repo
    [3269P.stp, 4_PIN_SSOP.STEP, CAP_EEE_A.step, D8.step, ESQ-102-24-G-D.stp, ESQ-120-24-T-D.stp, SOT-89.step, User Library-grove v1.step]
2021-12-01 rework wireless stats to use iw instead of deprecated iwconfig, even though iw is not recommended for output parsing.
2021-12-02 add create mountpoints option to sdimg_util
2021-12-04 Add new feature to view active member list from idle screen, press blue button whenever ACL stats are shown.
2021-12-05 move old raspbian config stuff to better named directory
    [config.txt]
2021-12-06 Rework SSL config options to make them more clear and split out MQTT client certs (always used) from HTTPS client certs (not used yet). Improve finding network device and MAC/node ID with fallbacks.
2021-12-07 move current sense stuff
    [AC1015.step, User Library-grove v1.step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]
2021-12-07 removed current_sense
    [AC1015.step, User Library-grove v1.step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]
2021-12-07 move integration dir
    [Bottom Half Plate for Arduino Screw Terminal Breakout.dxf, clamp_lower1.stl, clamp_lower2.stl, clamp_lower_sensor_12mm.stl, clamp_upper1.stl, clamp_upper2.stl, indicator_acrylic_3mm.dxf, indicator_bottom.stl]
2021-12-07 remove 'rpi' dir from firmware and move everything down a level
    [config.txt, templateconf.cfg]
2021-12-07 move yocto-build dir to yocto
    [templateconf.cfg]
2022-08-21 Documentation for Epilog wiring
2023-02-01 Add woodshop Alpha bandsaw wiring diagram
2023-02-01 deprecate Rabbit and Full Spectrum integrations
    [Bottom Half Plate for Arduino Screw Terminal Breakout.dxf]
2023-02-01 move Everlast TIG stuff to integrations directory
    [tig_interface.kicad_pcb, tig_interface.sch]
2026-04-10 UV Signal ground fix
2026-04-13 xTool UV Laser Integration
2026-04-18 Kern Laser Integration
